MinorAR/Fontys_SCARA_Arm/README.md

# Fontys SCARA Arm project
# More information on [Wiki](https://github.com/MinorAR/Fontys_SCARA_Arm/wiki)
