MinorAR/Fontys_SCARA_Arm/img/Poster-fontys-MinorAR.pdf

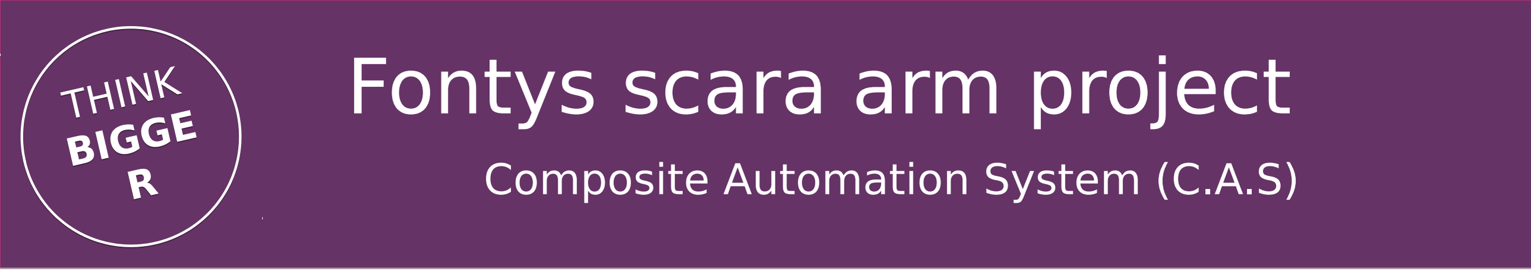
[picture p1: figure]
THINK BIGGE R; Fontys scara arm project; Composite Automation System (C.A.S)
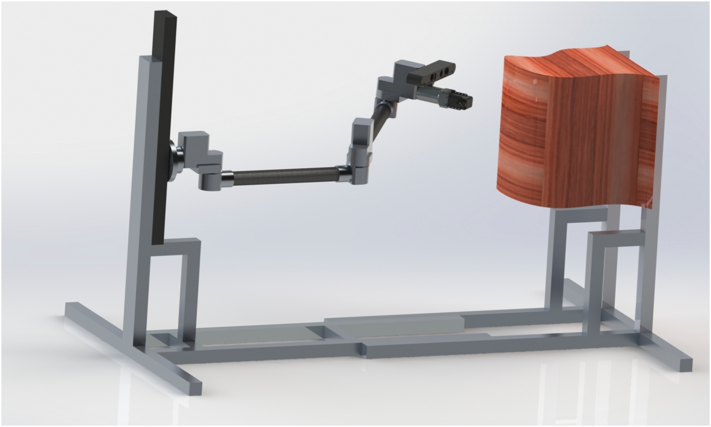
[picture p2: figure]
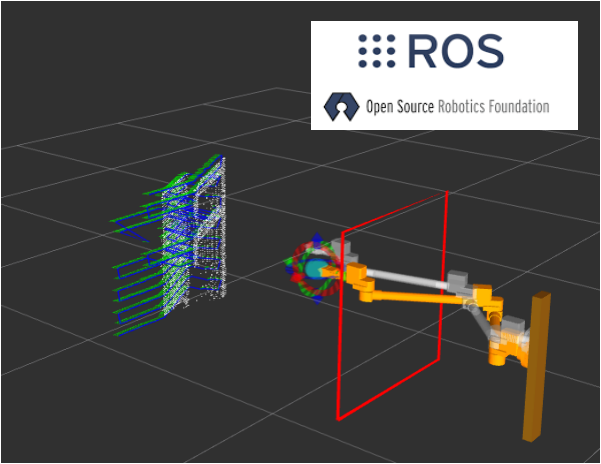
[picture p3: figure]
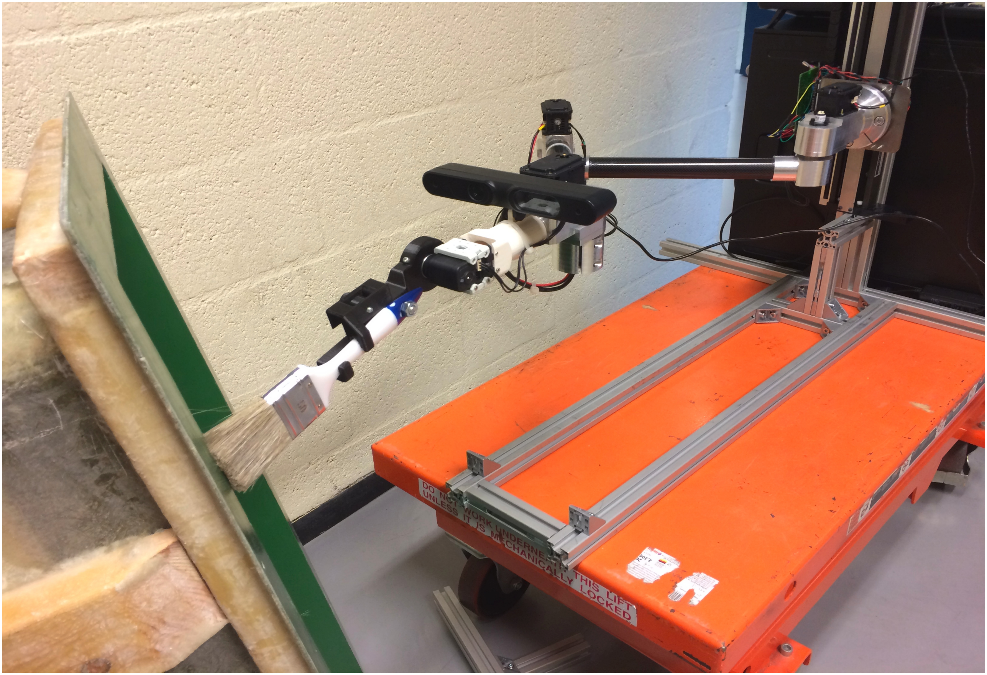
[picture p4: figure]
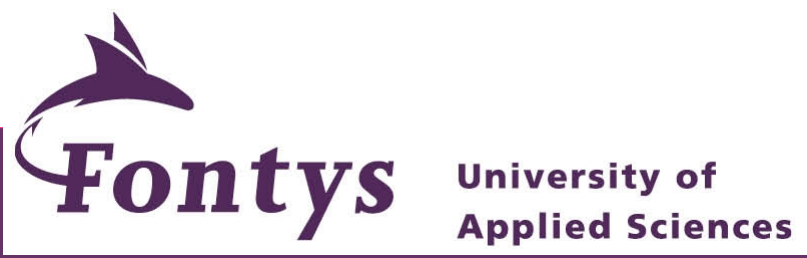
[picture p5: figure]

Fontys Hogeschool Engineering Rachelsmolen 1, 5612 MA
Eindhoven, The Netherlands

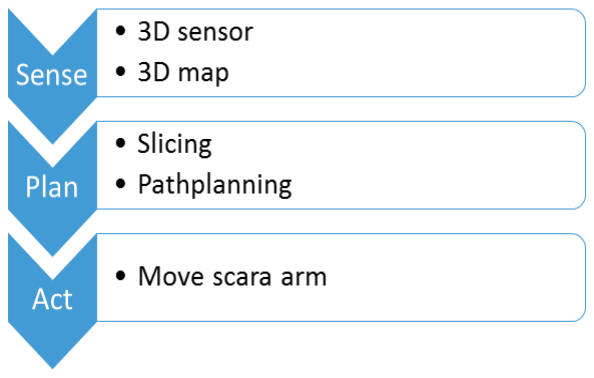
[picture p6: figure]

# Minor Adaptive Robotics

## https://github.com/MinorAR/Fontys_SCARA_Arm/wiki

## Introduction

This project within the minor Adaptive Robotics for the Fontys university of applied sciences engineerings department in Eindhoven (the Netherlands). As part of the Composite Automation System (C.A.S.)

## Project context

The process is about making products with composite materials which require a complex producing method which costs a lot of time. The following parts of process were interesting for this project which are: product polishing, cleaning the surface of the mold, and putting a gel coat. The purpose of this project is to deliver a working demonstrator that is able to detect a certain object and follow the surfaces.

## Powered by ROS

The Robot Operating System (ROS) is a flexible framework for writing robot software. It is a collection of tools, libraries, and conventions that aim to simplify the task of creating complex and robust robot behavior across a wide variety of robotic platforms.

Project members:
Ruud van Dommelen
Cas van Hoof
Wout Kanters
Jeroen Rikken
Lorenz Janssen
