MinorAR/Fontys_SCARA_Arm/src/pclcaptureing_positioning/README.md

# Service node for moveIt!

## Introduction
In this folder you will find information and all the files about how to create a node that offers a service in ROS. This service allows you to request a position that will be sent to a moveIt movegroup.

In the rqt-graph screenshot you can see that the node is present. The node contains a service and is connected to movegroup through several topics. (/trajectory_execution_event, pickup/action_topics, place/action_topics, /planning_scene and /attached collision_object).
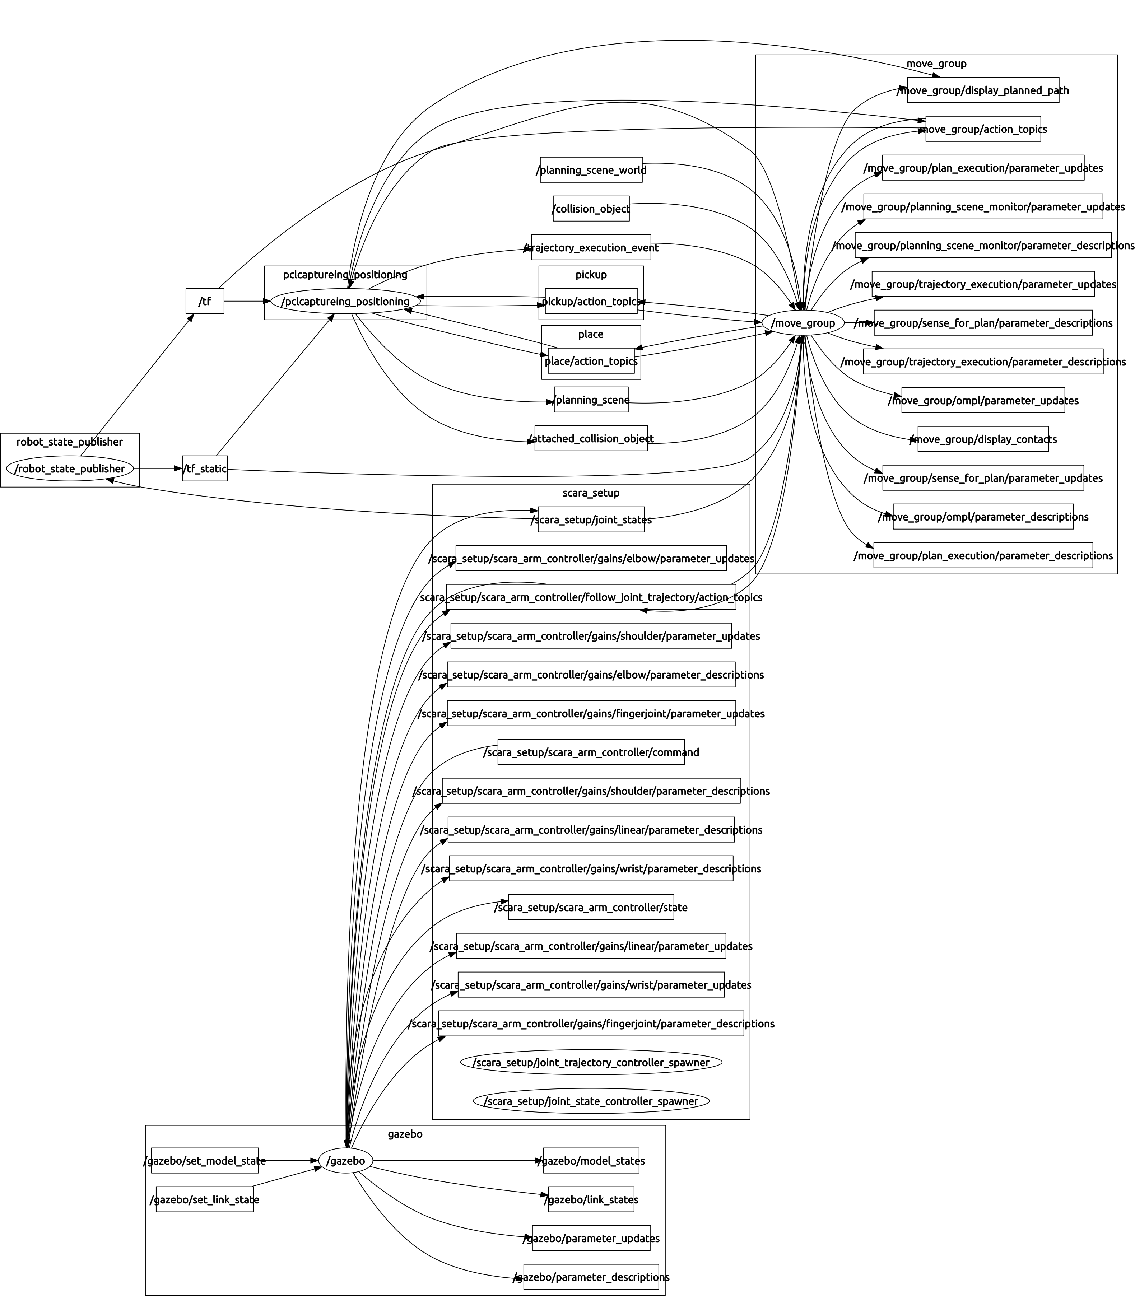
[picture p7: img/rosgraph.png]
Image of Graph


## how to use
As you can see in the picture below, the service is called with a rosservice call. You can enter the values you want to reach end the node will make sure the robot arm gets to this position. These values quaternion coordinates.
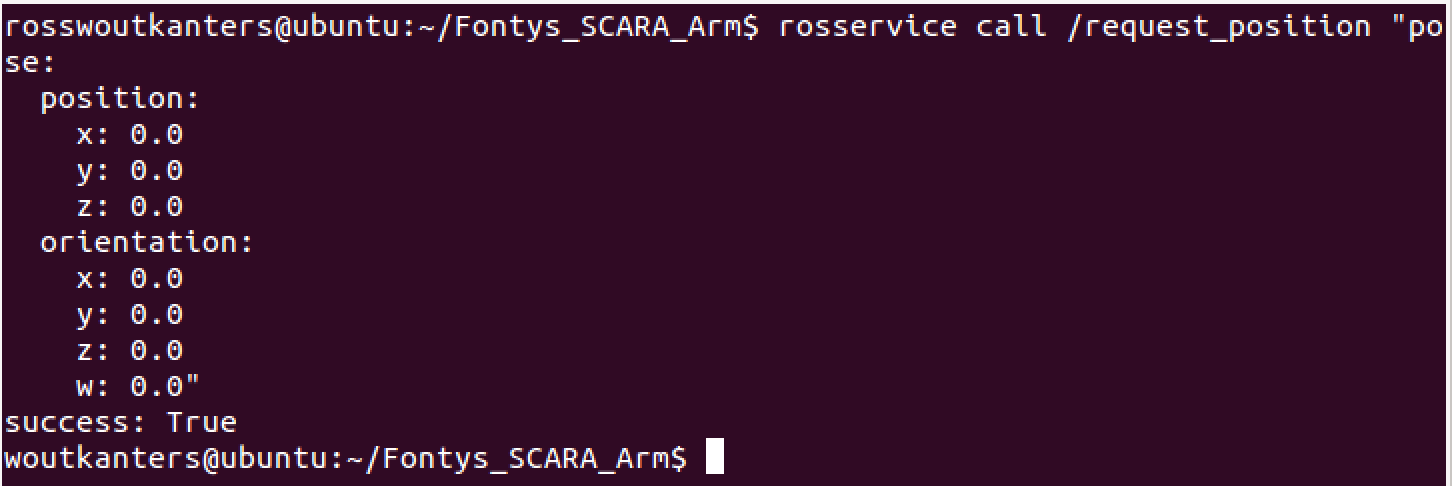
[picture p8: img/srvcall.png]
Image of Servicecall

You can see that the node sends an acknowlage back to the terminal.

## Folder contents
This is a catkin created package so the folders and most documents are automatically generated. also see: http://wiki.ros.org/catkin/Tutorials/create_a_workspace 

In the [src folder](https://github.com/MinorAR/Fontys_SCARA_Arm/tree/master/src/pclcaptureing_positioning/src) I created a C++ node for the service call.

In the [Launch folder](https://github.com/MinorAR/Fontys_SCARA_Arm/tree/master/src/pclcaptureing_positioning/launch) I created a launch file to automatically launch all vital pats of the node.

In the [srv folder](https://github.com/MinorAR/Fontys_SCARA_Arm/tree/master/src/pclcaptureing_positioning/srv) I added a service file which includes the information about how to service is build. In my case I used the /pose topic.

In this folder you can find the Cmakelist which is ajusted to compile all the parts of this folder correct.
