MinorAR/Fontys_SCARA_Arm/img/ArchitectureOverview.PNG

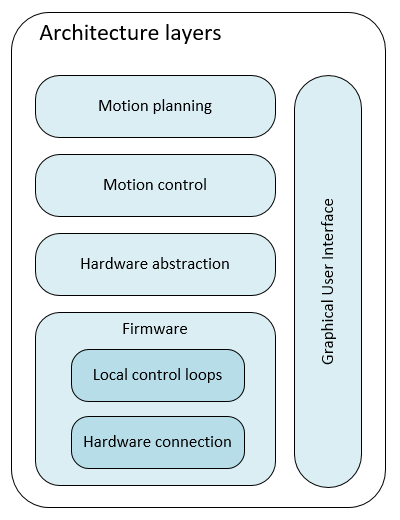
img/ArchitectureOverview.PNG
