MinorAR/Fontys_SCARA_Arm/img/Blindspots_Vision.png

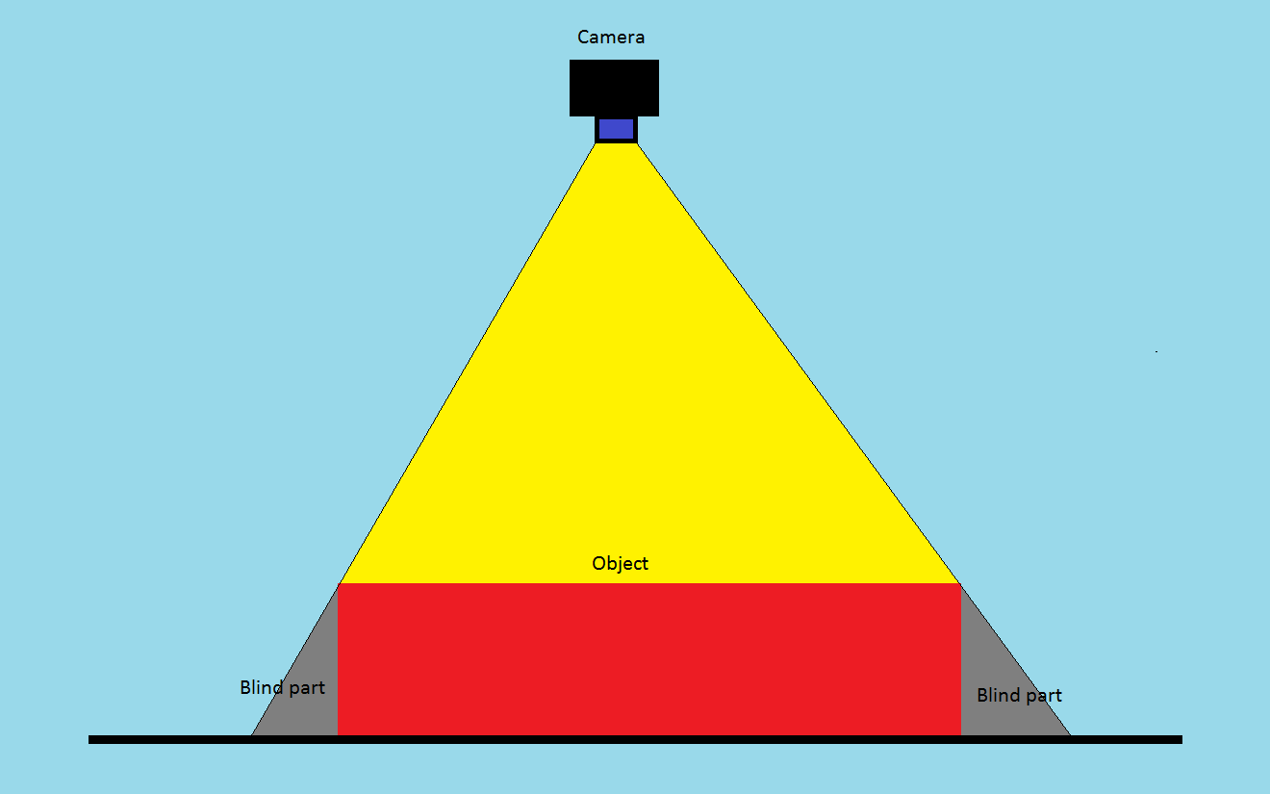
img/Blindspots_Vision.png
