MinorAR/Fontys_SCARA_Arm/img/ControlModuleOverview.png

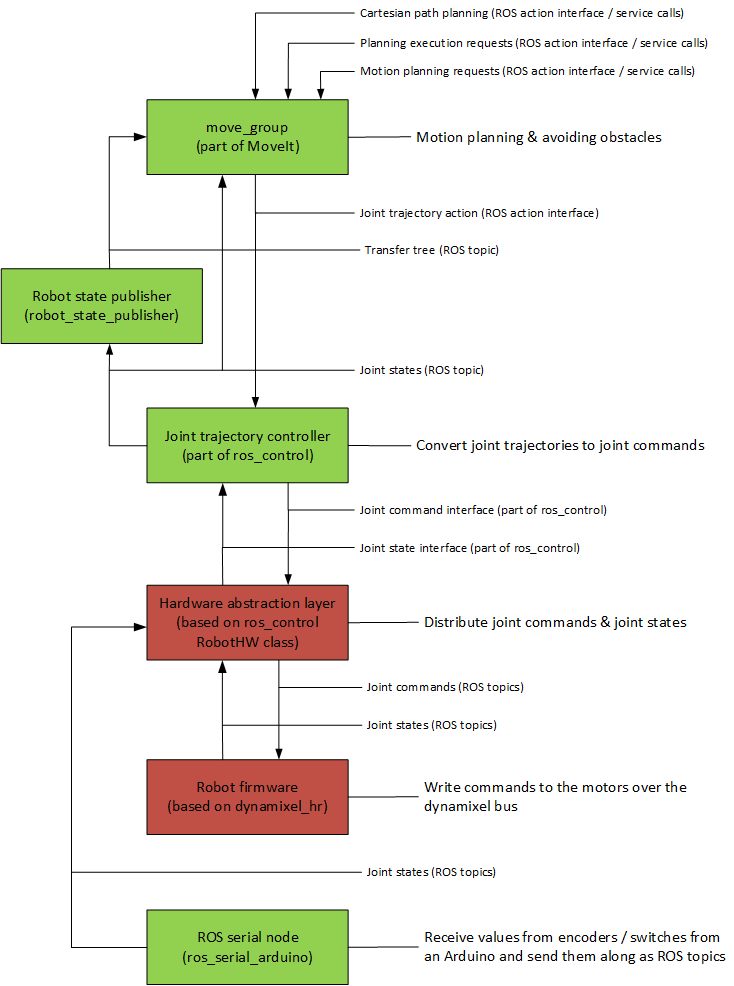
img/ControlModuleOverview.png
