MinorAR/Fontys_SCARA_Arm/img/Dynamixel_AX-12-spec.png

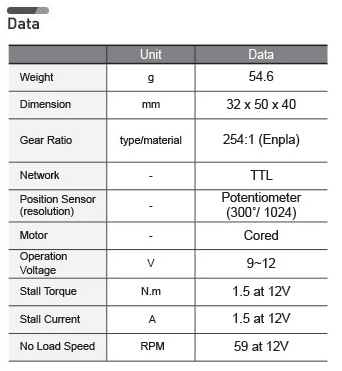
img/Dynamixel_AX-12-spec.png
