MinorAR/Fontys_SCARA_Arm/img/Dynamixel_MX-64-spec.png

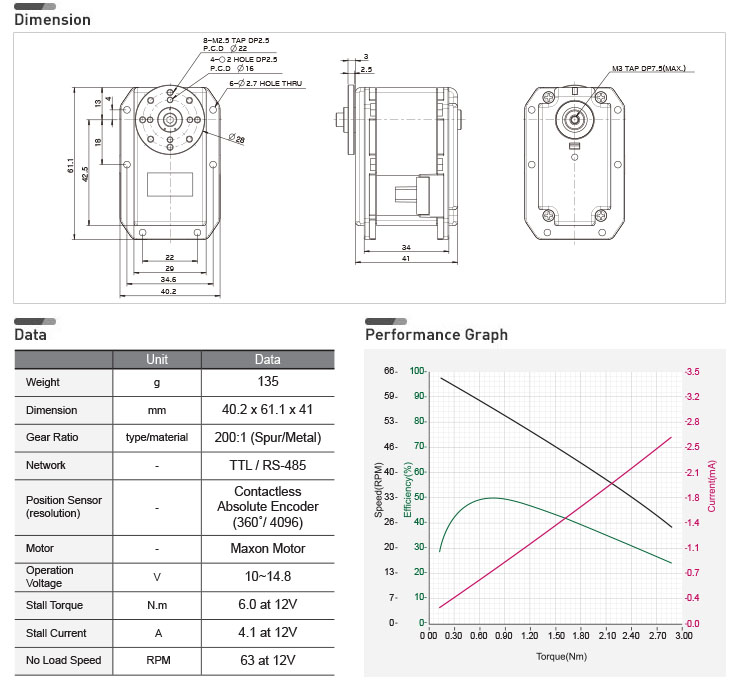
img/Dynamixel_MX-64-spec.png
