MinorAR/Fontys_SCARA_Arm/img/flowchartVS.png

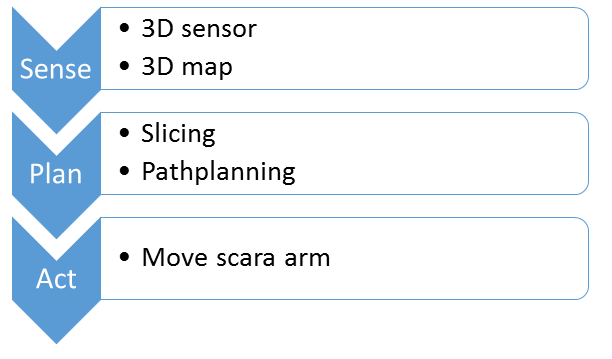
img/flowchartVS.png
