MinorAR/Fontys_SCARA_Arm/img/foto frame cad.png

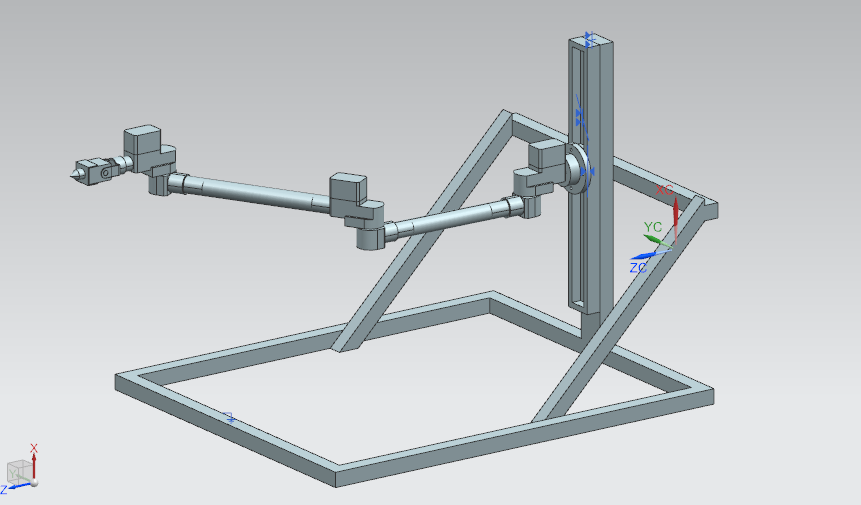
img/foto frame cad.png
