MinorAR/Fontys_SCARA_Arm/img/global block diagram.png

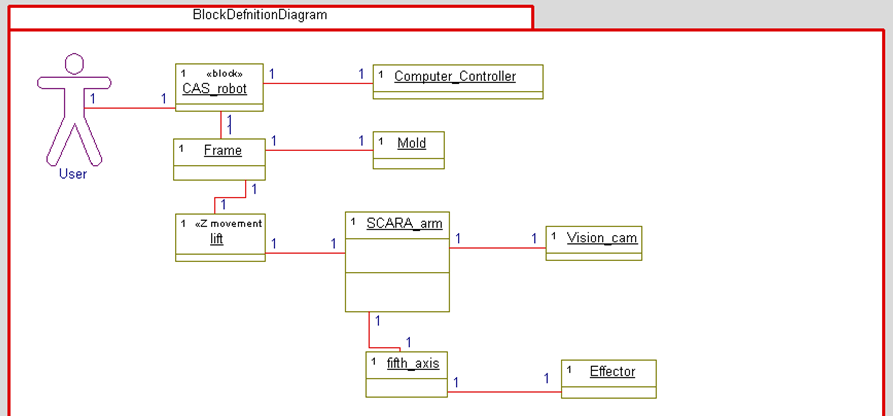
img/global block diagram.png
