MinorAR/Fontys_SCARA_Arm/img/header.png

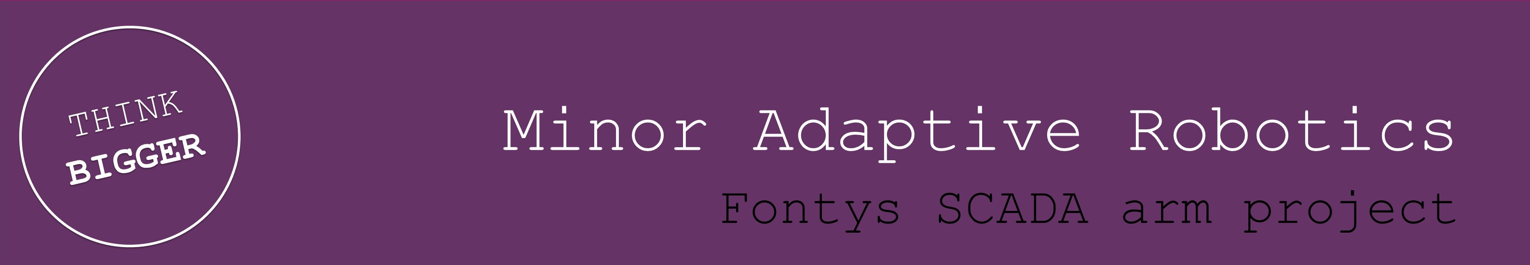
img/header.png
