MinorAR/Fontys_SCARA_Arm/img/process digitaal.PNG

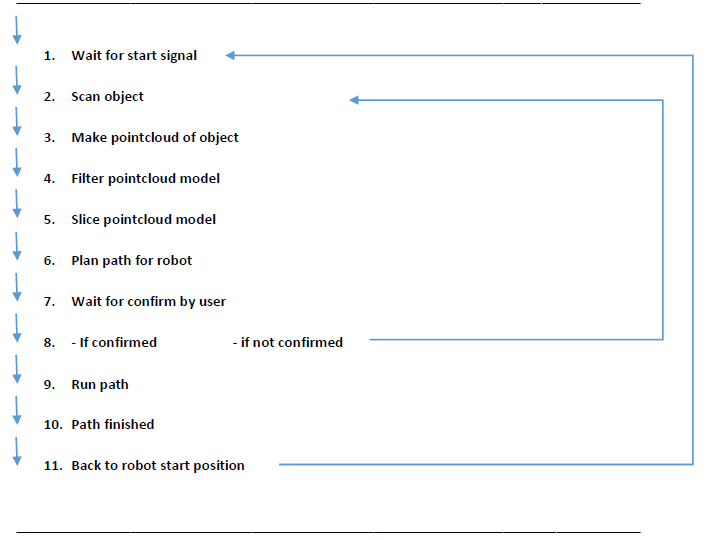
img/process digitaal.PNG
