MinorAR/Fontys_SCARA_Arm/img/Safety Check.png

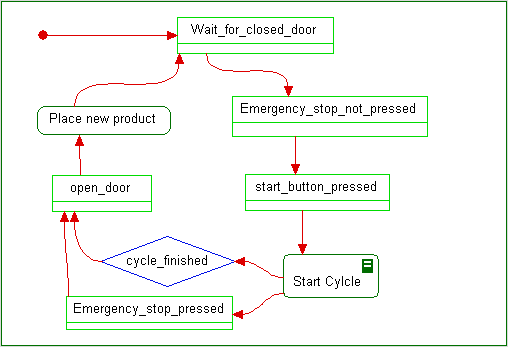
img/Safety Check.png
