MinorAR/Fontys_SCARA_Arm/img/Safety Zone.png

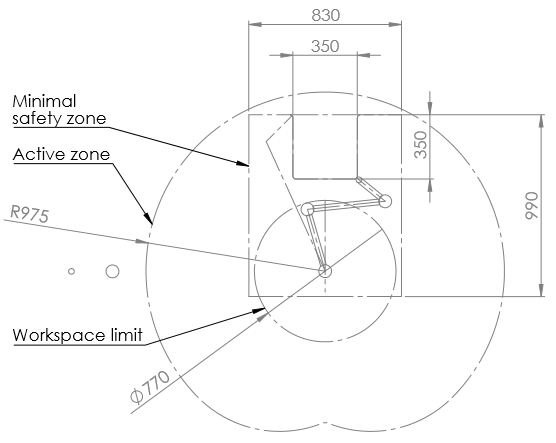
img/Safety Zone.png
