MinorAR/Fontys_SCARA_Arm/img/SCARA_pic_1.png

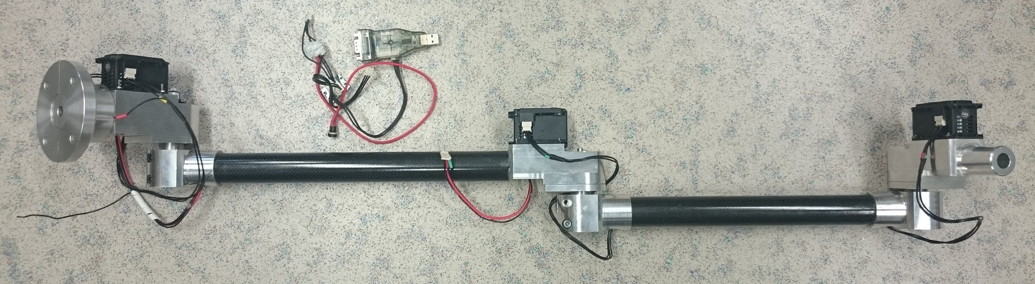
img/SCARA_pic_1.png
