MinorAR/Fontys_SCARA_Arm/img/SCARA_pic_2.png

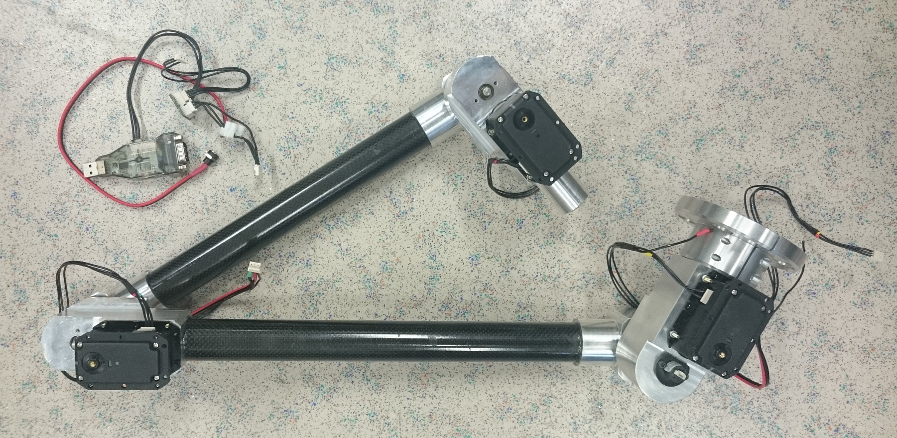
img/SCARA_pic_2.png
