MinorAR/Fontys_SCARA_Arm/img/scaradimensions.png

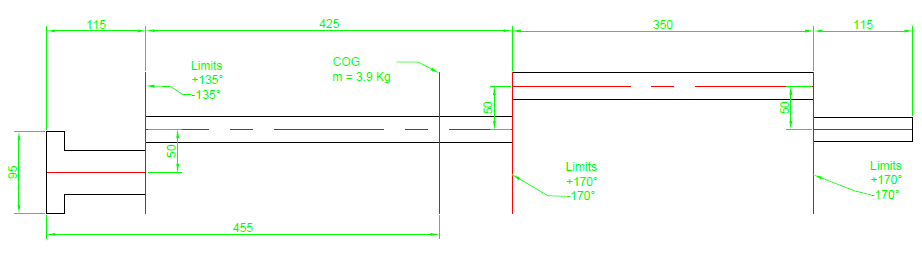
img/scaradimensions.png
