MinorAR/Fontys_SCARA_Arm/img/Screenshot from 2016-06-09 13:05:24.png

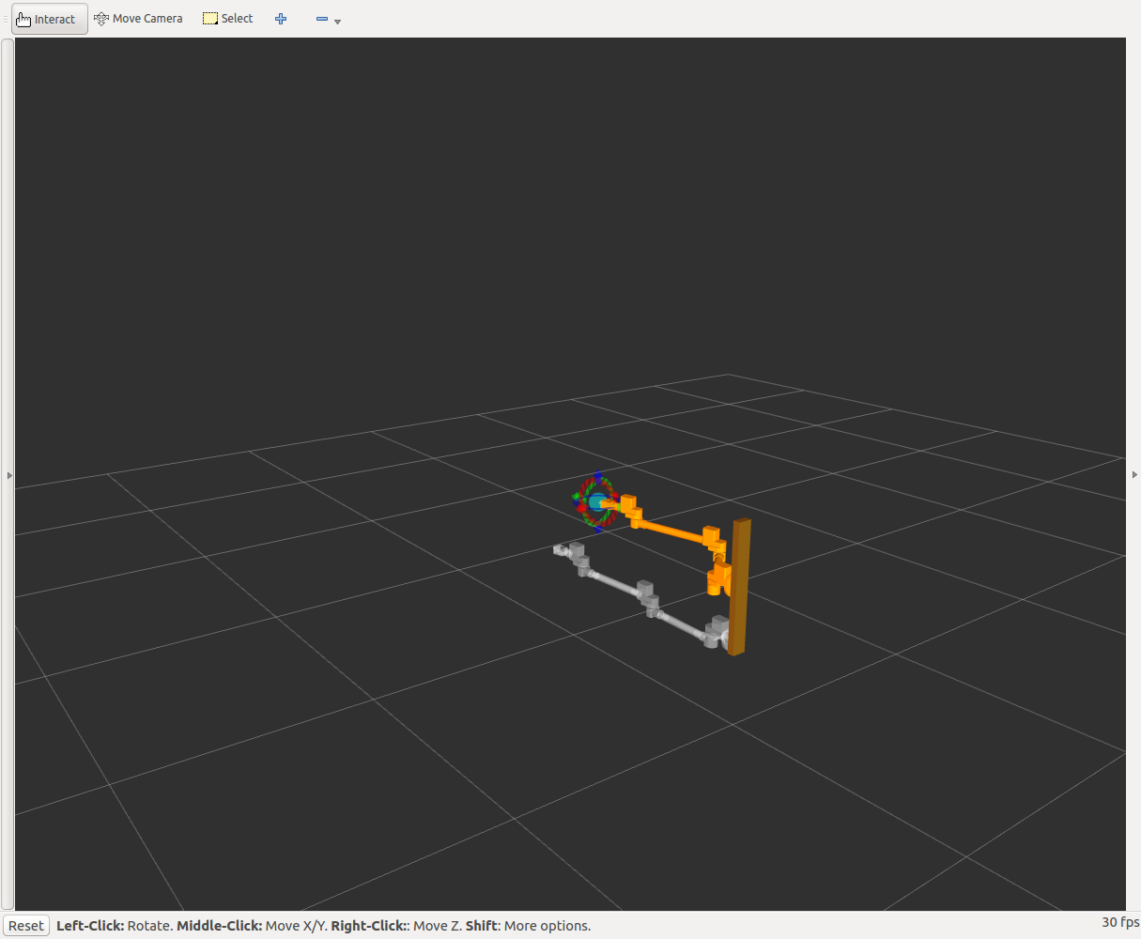
img/Screenshot from 2016-06-09 13:05:24.png
