MinorAR/Fontys_SCARA_Arm/img/Screenshot from 2016-06-09 13:08:11.png

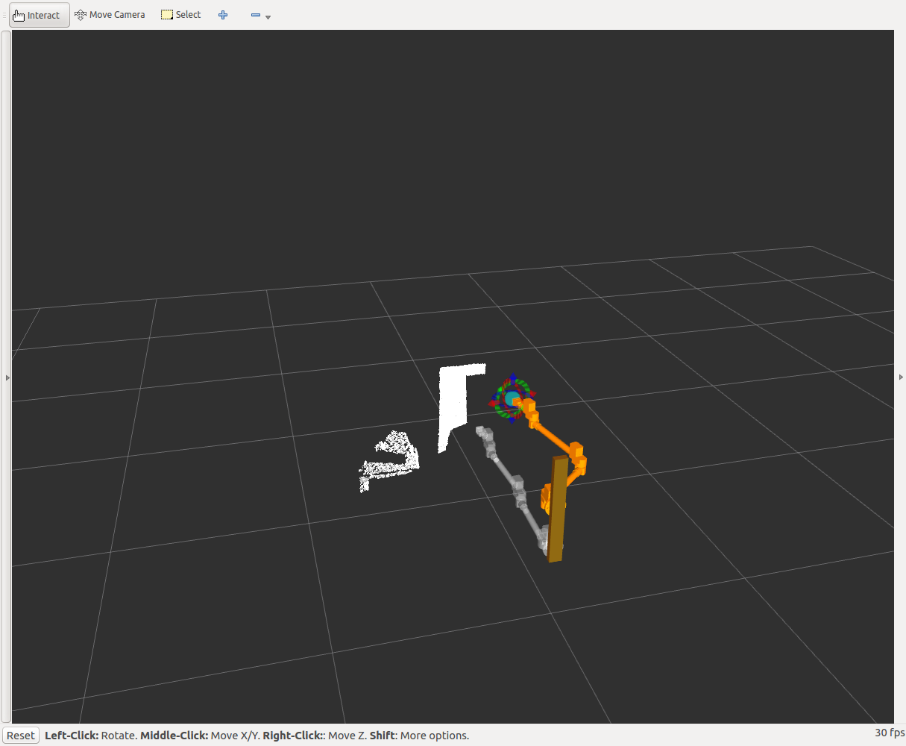
img/Screenshot from 2016-06-09 13:08:11.png
