MinorAR/Fontys_SCARA_Arm/img/Screenshot from 2016-06-09 13:09:03.png

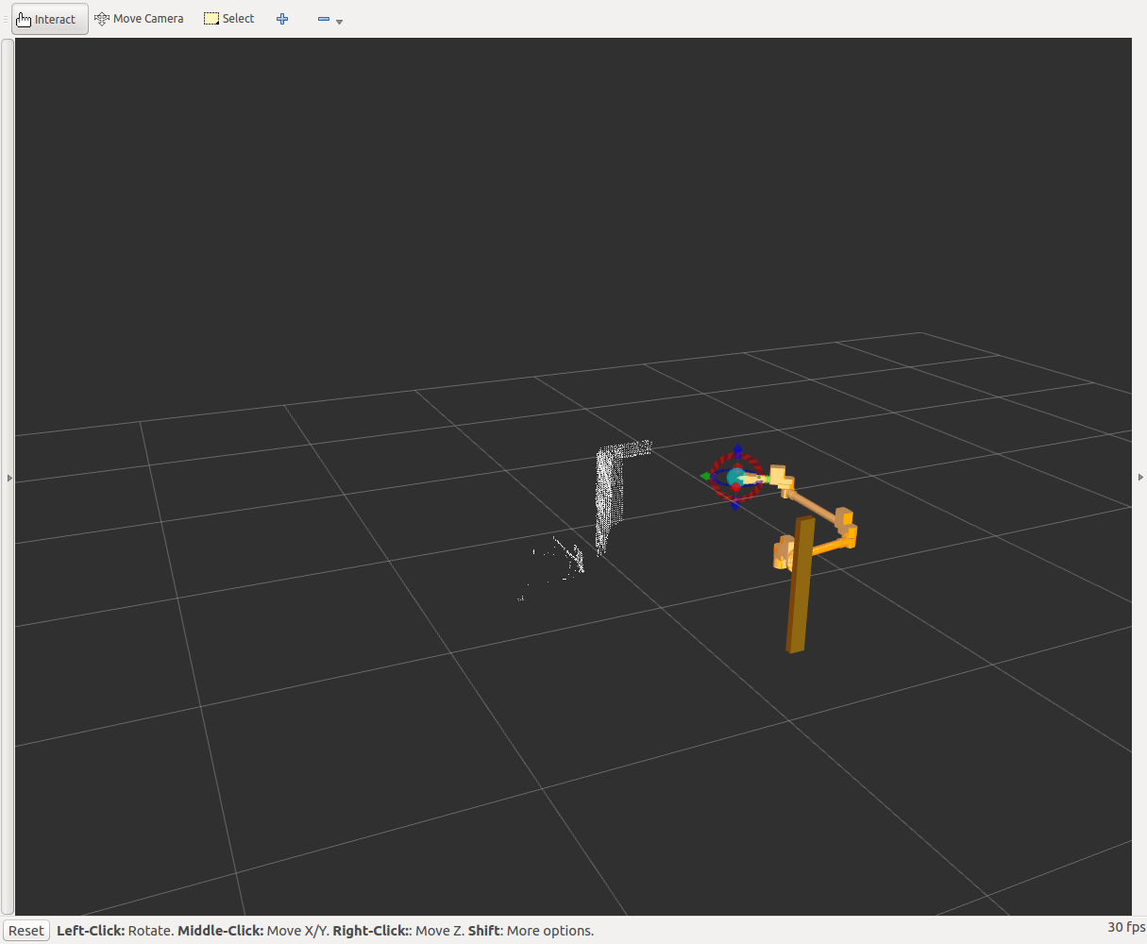
img/Screenshot from 2016-06-09 13:09:03.png
