MinorAR/Fontys_SCARA_Arm/img/servicecall.png

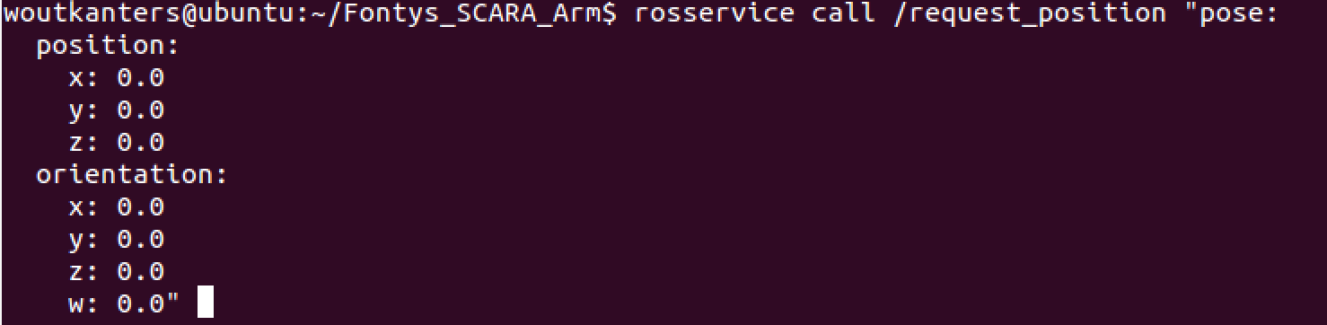
img/servicecall.png
