MinorAR/Fontys_SCARA_Arm/img/situatie1.png

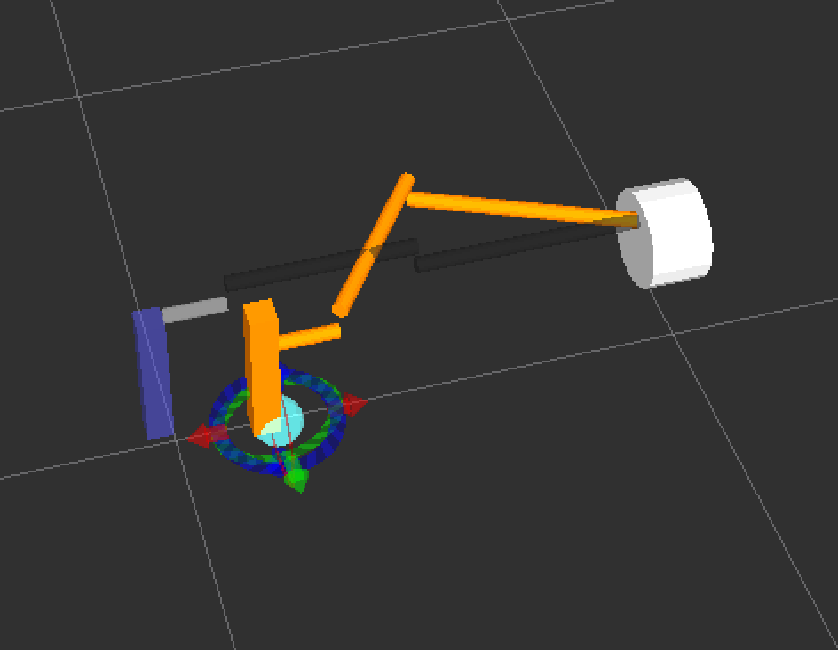
img/situatie1.png
