MinorAR/Fontys_SCARA_Arm/img/situatie2.png

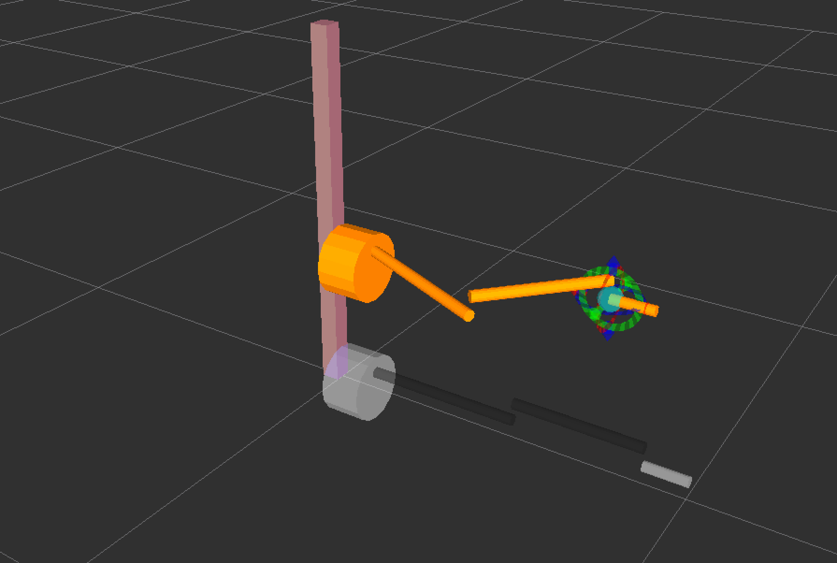
img/situatie2.png
