MinorAR/Fontys_SCARA_Arm/img/situatie3.png

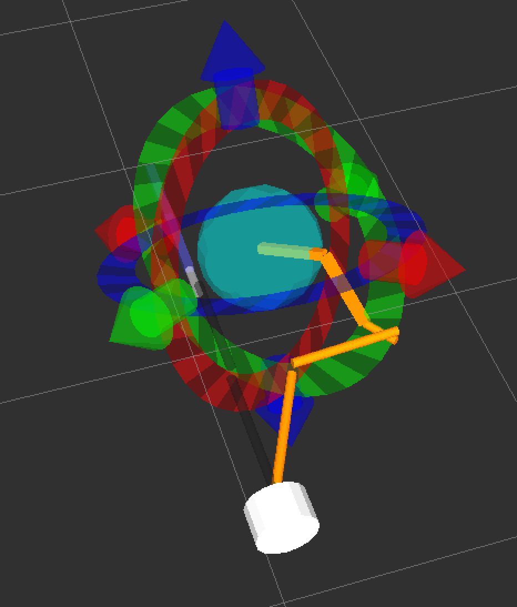
img/situatie3.png
