MinorAR/Fontys_SCARA_Arm/img/MoveItComponents.png

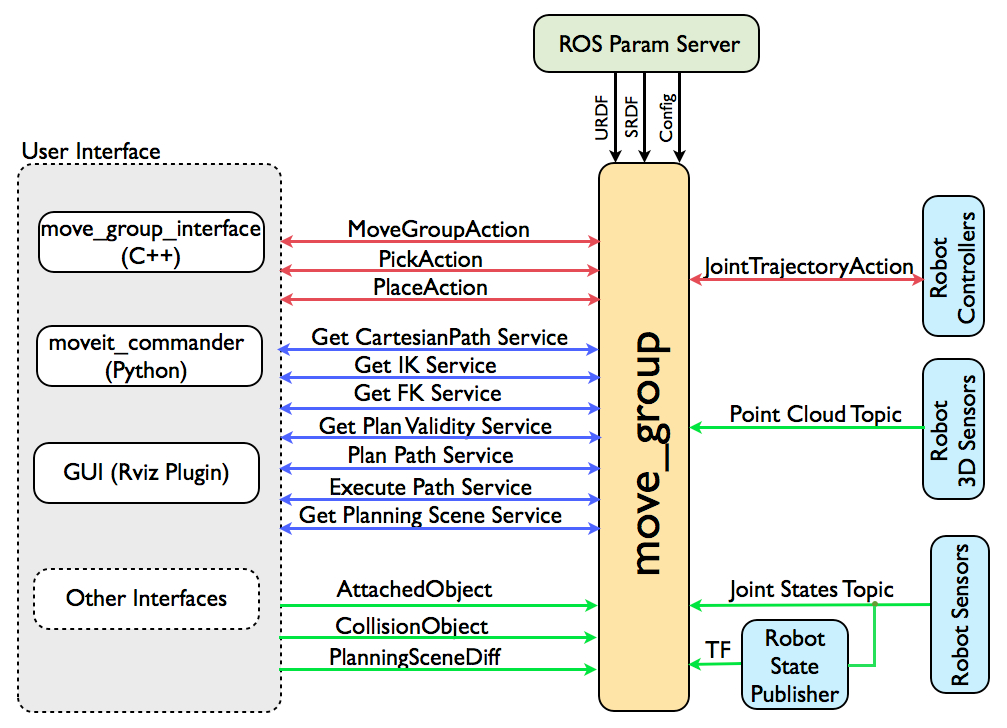
img/MoveItComponents.png
