MinorAR/Fontys_SCARA_Arm/CAD/total assembly.SLDASM

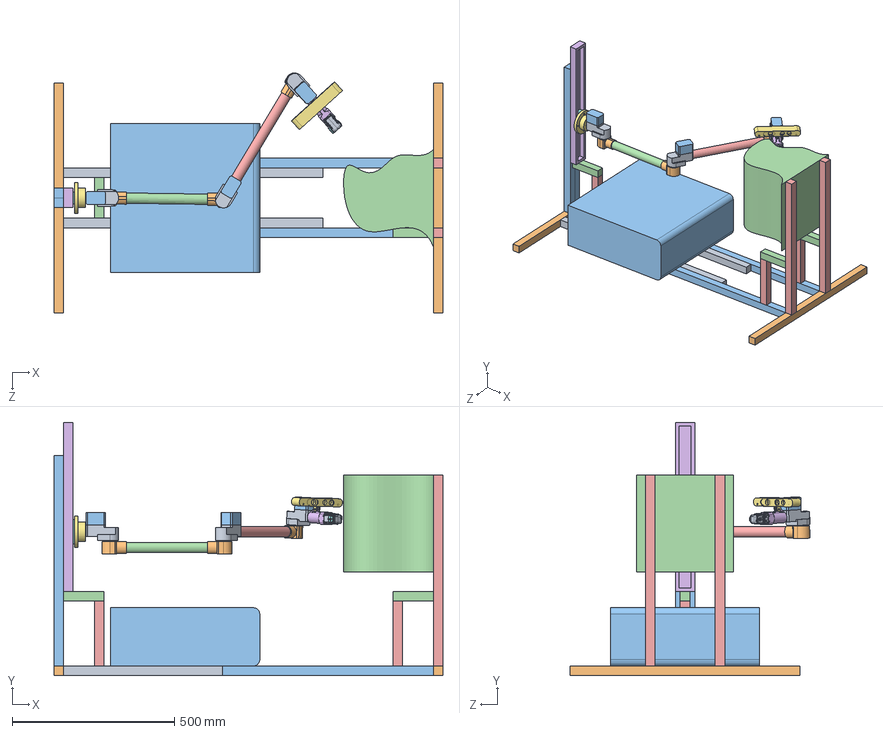
[picture p33: CAD file, 2016-06-23]
CAD/total assembly.SLDASM
1200.0 x 782.0 x 740.3 mm
30x800 x 2
30x710 x 2
30x650 x 4
30x125 x 5
30x200 x 3
LinearGuide
Base
LinearGuideCart
Joint_Motor_Side x 3
Joint_Passive_Side x 3
Motor_MX-64 x 3
Arm
ForeArm
end effector beugel
camera_sldprt
ax12_wheel
ax12_box
ax12_cog
pc
object 300x300x300
30x590 x 2
