MinorAR/Fontys_SCARA_Arm/CAD/mechanical make parts cad/Assem1.SLDASM

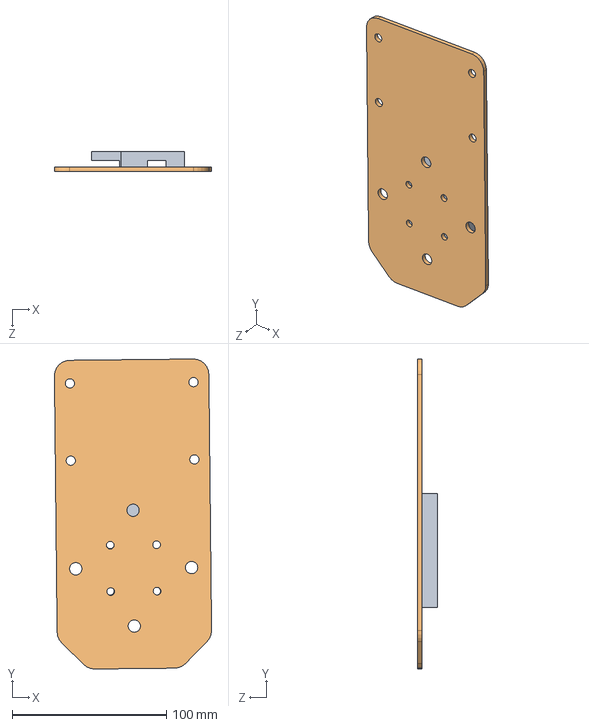
[picture p34: CAD file, 2016-06-23]
CAD/mechanical make parts cad/Assem1.SLDASM
101.7 x 200.7 x 13.0 mm
bevestigingplaat van lift
bevestigingsflens voor arm
