MinorAR/Fontys_SCARA_Arm/CAD/AX12.SLDASM

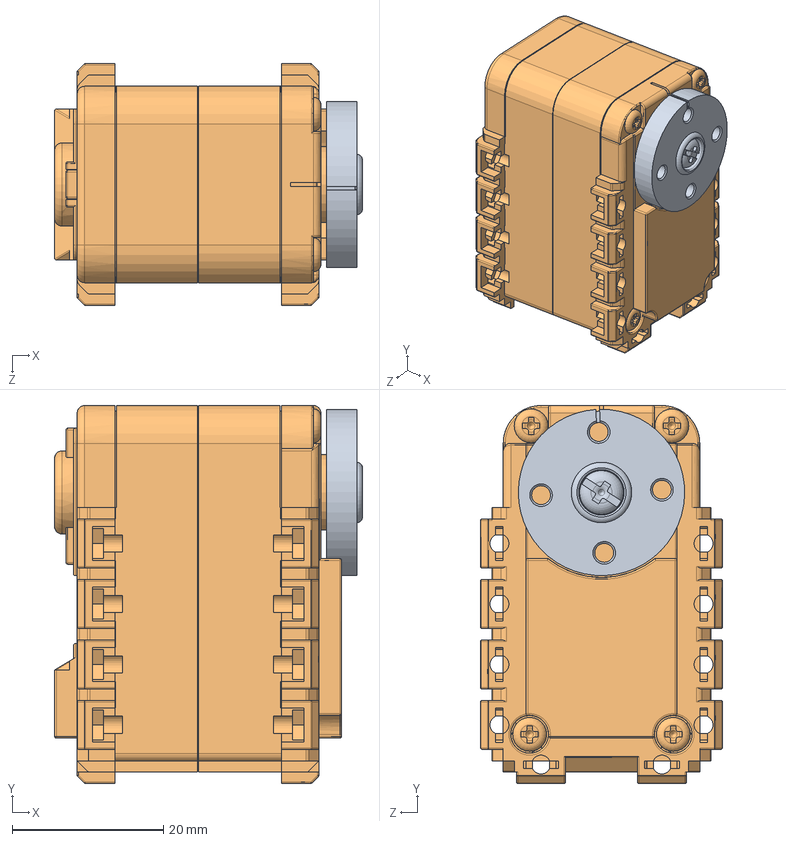
[picture p35: CAD file, 2016-06-23]
CAD/AX12.SLDASM
40.8 x 50.0 x 32.0 mm
ax12_wheel
ax12_box
ax12_cog
