MinorAR/Fontys_SCARA_Arm/CAD/effector1/assembly effector.SLDASM

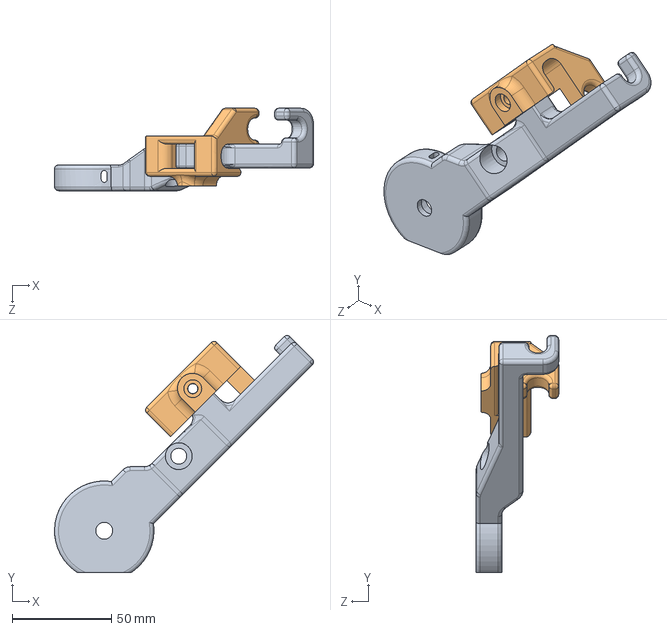
[picture p36: CAD file, 2016-06-23]
CAD/effector1/assembly effector.SLDASM
130.2 x 119.2 x 41.5 mm
effector
klem effector
