MinorAR/Fontys_SCARA_Arm/CAD/frame/frame assembly.SLDASM

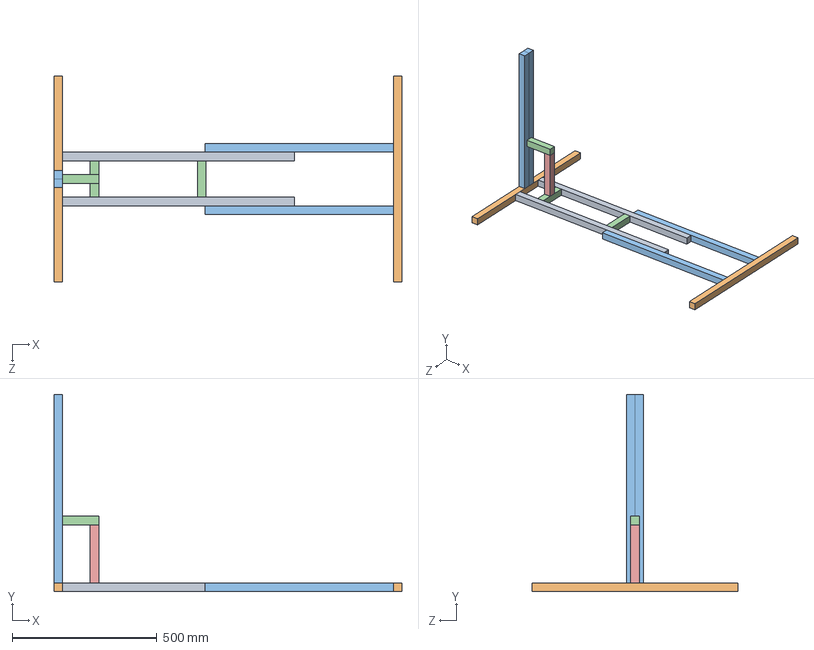
[picture p37: CAD file, 2016-06-23]
CAD/frame/frame assembly.SLDASM
1200.0 x 680.0 x 710.0 mm
30x800 x 2
30x710 x 2
30x650 x 4
30x125 x 3
30x200
