MinorAR/Fontys_SCARA_Arm/CAD/effector1/effector.SLDPRT

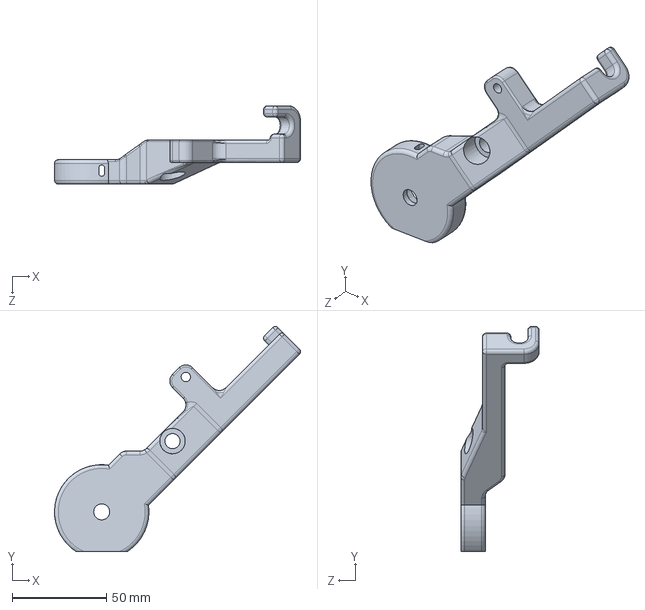
[picture p38: CAD file, 2016-06-23]
CAD/effector1/effector.SLDPRT
130.2 x 119.2 x 41.5 mm
