MinorAR/Fontys_SCARA_Arm/CAD/effector1/for printing/klem effector.STL

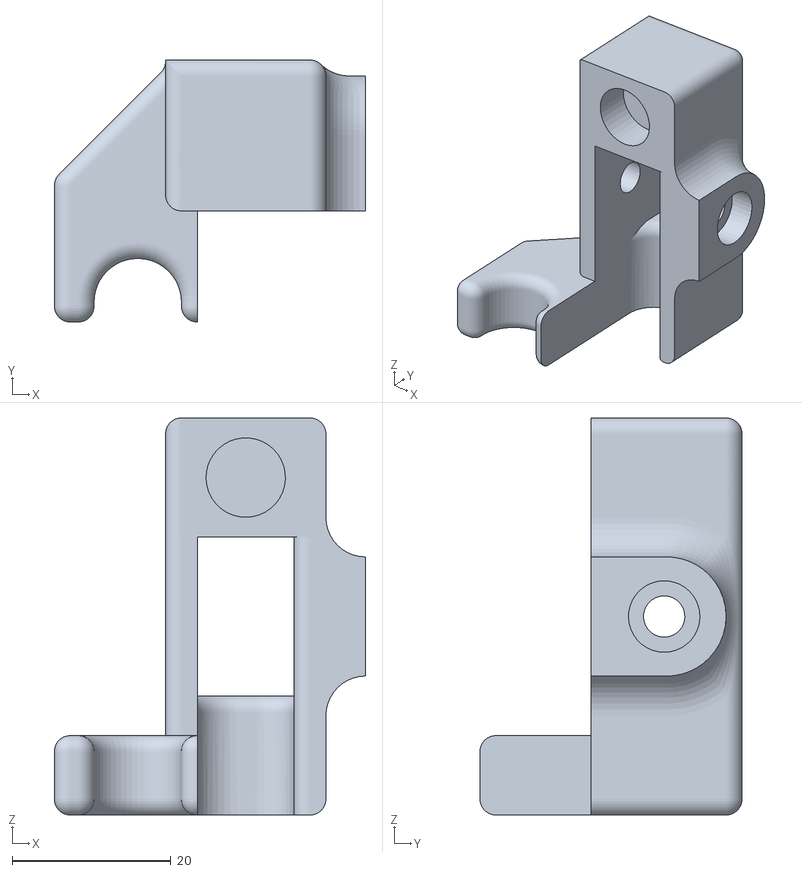
[picture p39: CAD file, 2016-06-23]
CAD/effector1/for printing/klem effector.STL
39.2 x 33.0 x 50.0
