MinorAR/Fontys_SCARA_Arm/CAD/frame/30x800.SLDPRT

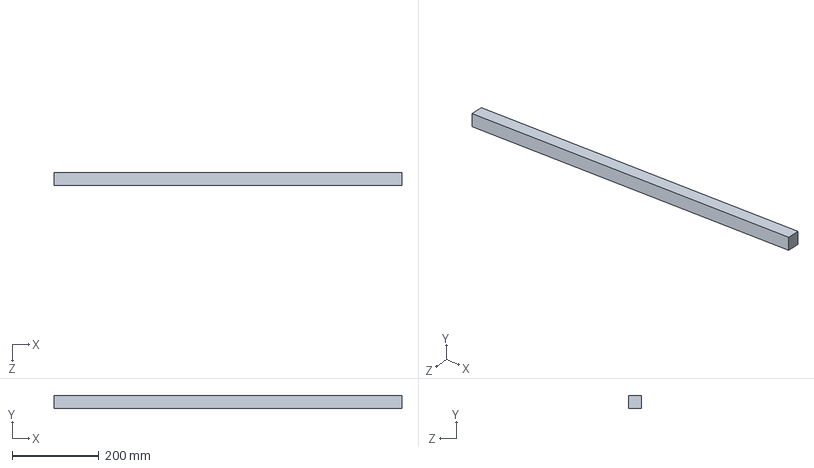
[picture p40: CAD file, 2016-06-23]
CAD/frame/30x800.SLDPRT
800.0 x 30.0 x 30.0 mm
