MinorAR/Fontys_SCARA_Arm/CAD/mechanical make parts cad/bevestigingplaat van lift.SLDPRT

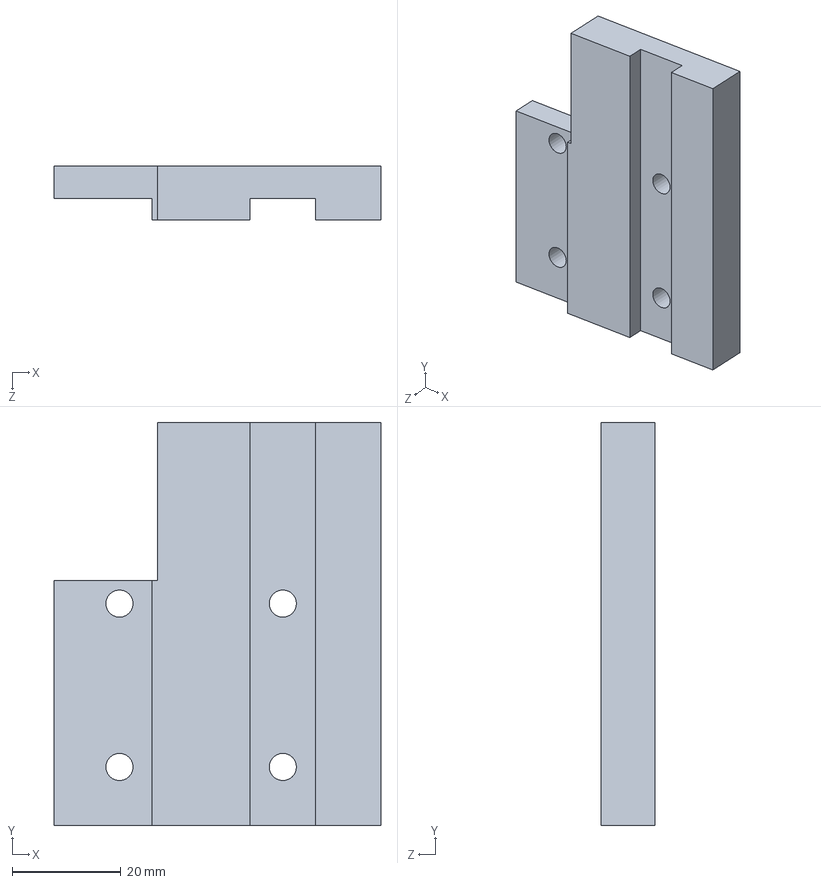
[picture p41: CAD file, 2016-06-23]
CAD/mechanical make parts cad/bevestigingplaat van lift.SLDPRT
60.0 x 74.0 x 10.0 mm
