MinorAR/Fontys_SCARA_Arm/CAD/pc.SLDPRT

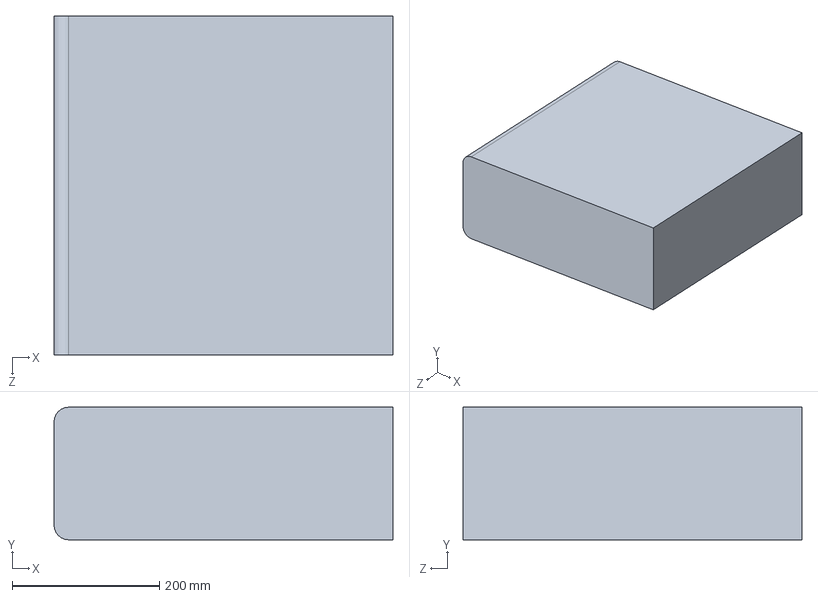
[picture p42: CAD file, 2016-06-23]
CAD/pc.SLDPRT
460.0 x 180.0 x 460.0 mm
