MinorAR/Fontys_SCARA_Arm/src/scara_setup_description/meshes/arm.STL

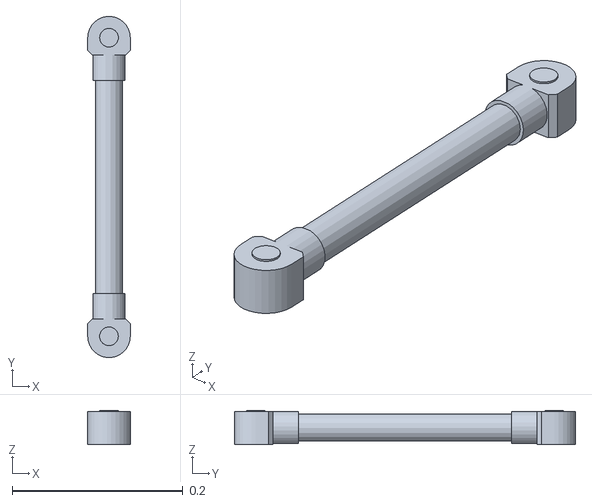
[picture p43: CAD file, 2016-05-09]
src/scara_setup_description/meshes/arm.STL
0.05 x 0.4 x 0.04
