MinorAR/Fontys_SCARA_Arm/CAD/effector1/clutch.SLDPRT

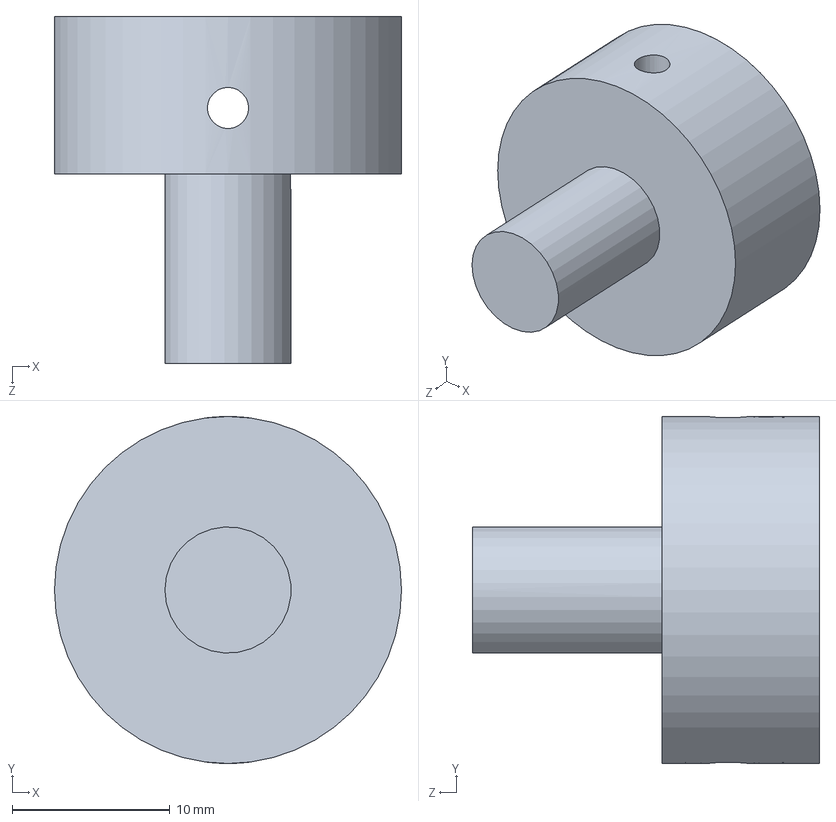
[picture p44: CAD file, 2016-06-23]
CAD/effector1/clutch.SLDPRT
22.0 x 22.0 x 22.0 mm
