MinorAR/Fontys_SCARA_Arm/CAD/frame/30x590.SLDPRT

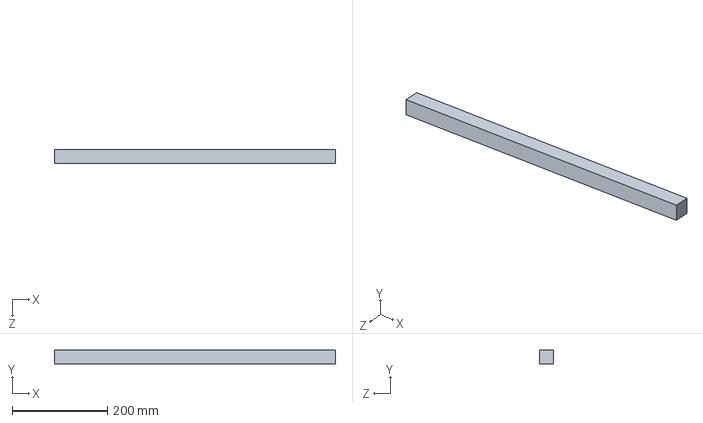
[picture p45: CAD file, 2016-06-23]
CAD/frame/30x590.SLDPRT
590.0 x 30.0 x 30.0 mm
