MinorAR/Fontys_SCARA_Arm/CAD/mechanical make parts cad/bevestigingsflens voor arm.SLDPRT

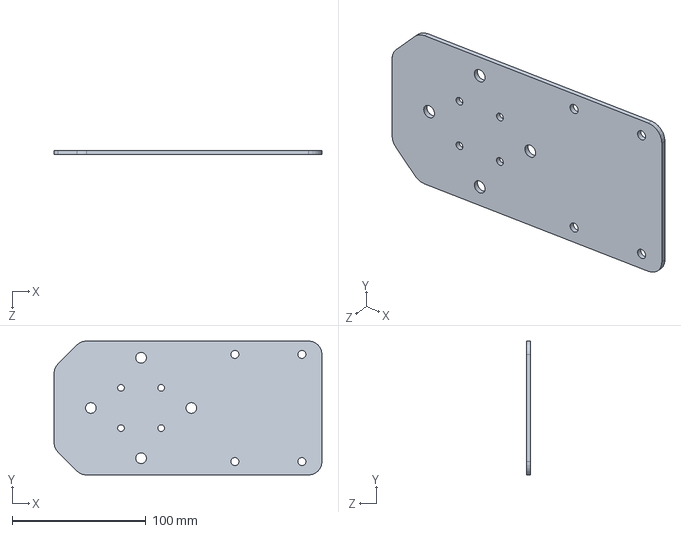
[picture p46: CAD file, 2016-06-23]
CAD/mechanical make parts cad/bevestigingsflens voor arm.SLDPRT
200.0 x 100.0 x 3.00 mm
