MinorAR/Fontys_SCARA_Arm/src/scara_setup_description/meshes/cart.STL

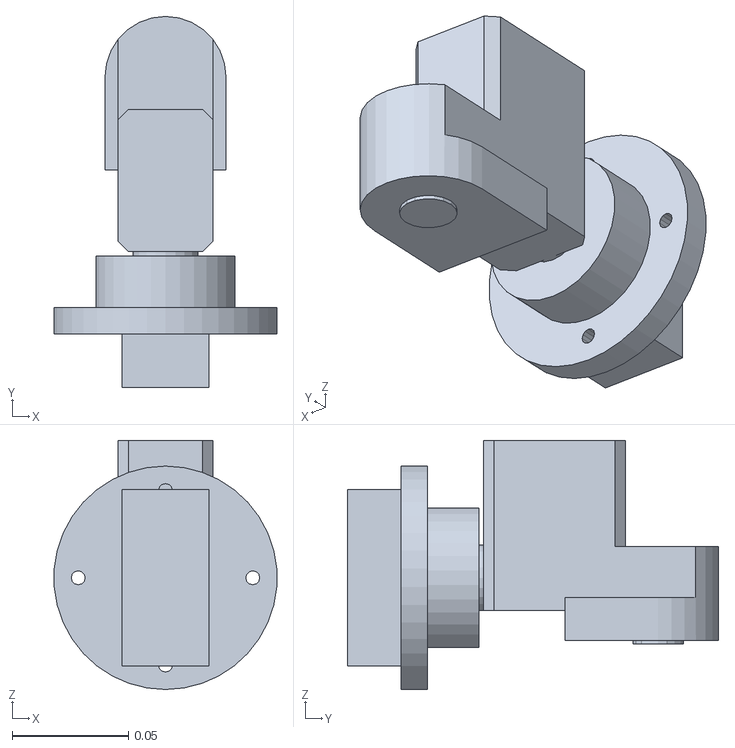
[picture p47: CAD file, 2016-05-09]
src/scara_setup_description/meshes/cart.STL
0.0957 x 0.16 x 0.107
