MinorAR/Fontys_SCARA_Arm/CAD/frame/30x200.SLDPRT

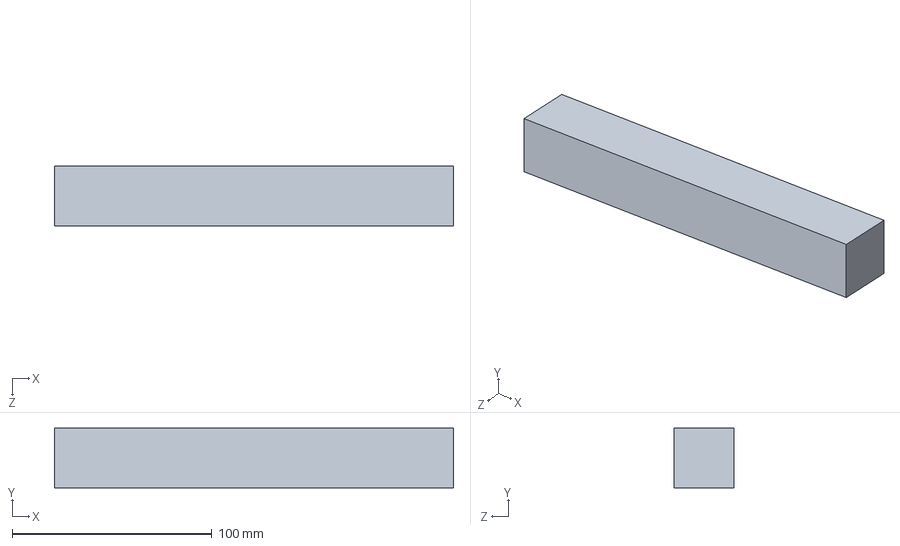
[picture p48: CAD file, 2016-06-23]
CAD/frame/30x200.SLDPRT
200.0 x 30.0 x 30.0 mm
