MinorAR/Fontys_SCARA_Arm/CAD/object 300x300x300.SLDPRT

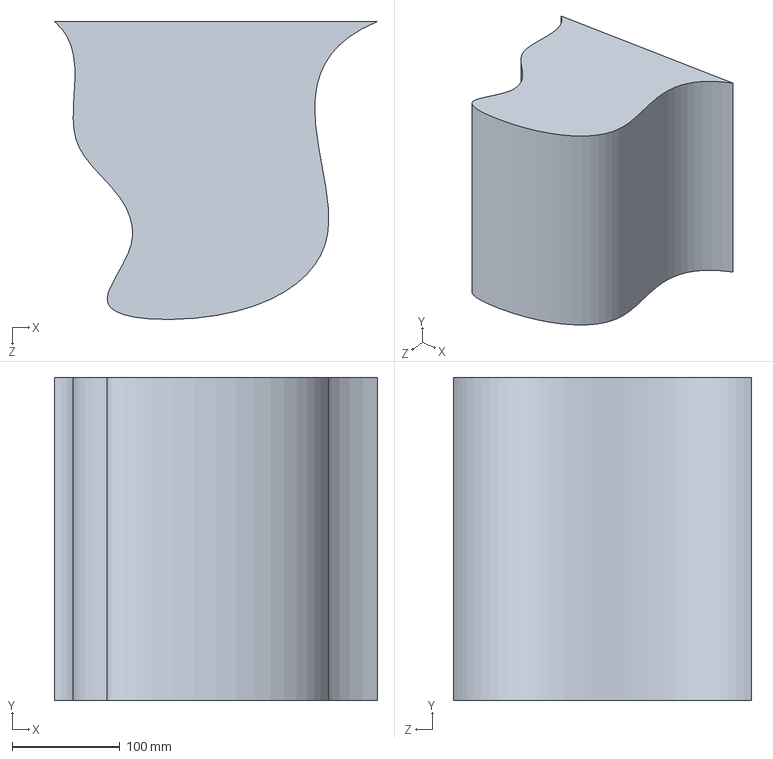
[picture p49: CAD file, 2016-06-23]
CAD/object 300x300x300.SLDPRT
300.0 x 300.0 x 276.7 mm
