MinorAR/Fontys_SCARA_Arm/src/scara_setup_description/meshes/forearm.STL

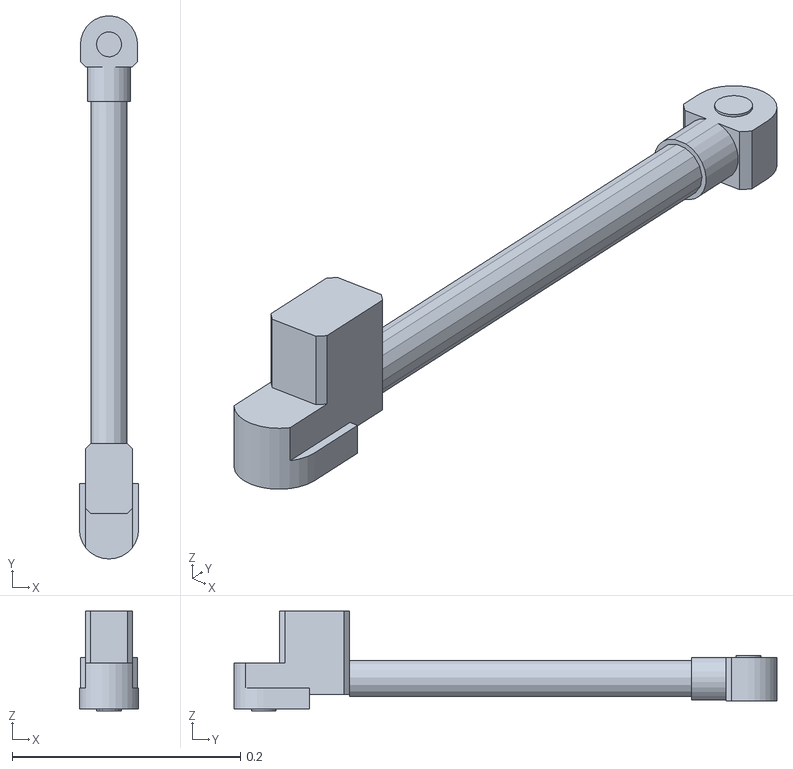
[picture p50: CAD file, 2016-05-09]
src/scara_setup_description/meshes/forearm.STL
0.052 x 0.476 x 0.0875
