MinorAR/Fontys_SCARA_Arm/CAD/frame/30x710.SLDPRT

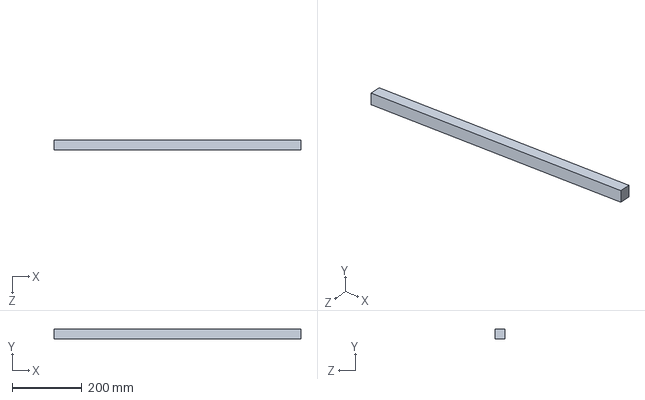
[picture p51: CAD file, 2016-06-23]
CAD/frame/30x710.SLDPRT
710.0 x 30.0 x 30.0 mm
