MinorAR/Fontys_SCARA_Arm/src/scara_setup_description/meshes/frame.STL

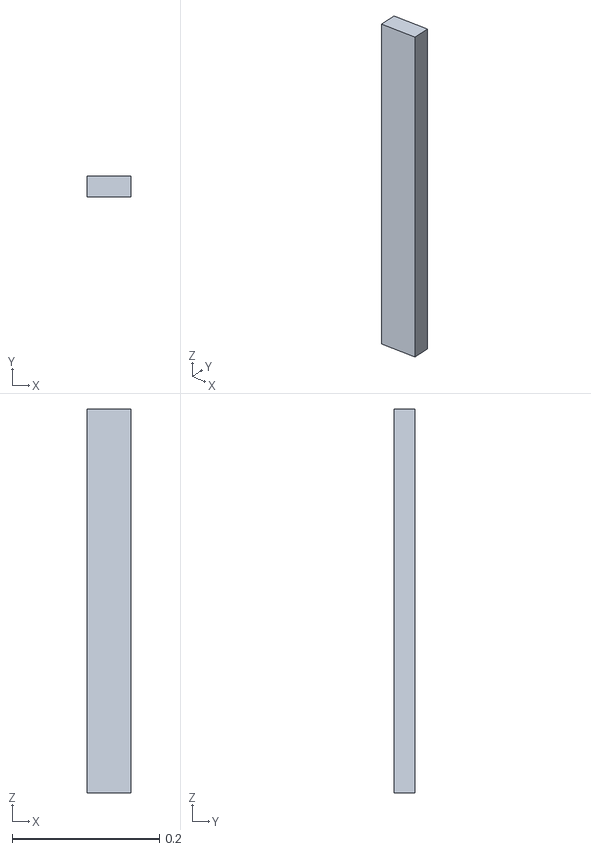
[picture p52: CAD file, 2016-05-09]
src/scara_setup_description/meshes/frame.STL
0.06 x 0.029 x 0.522
