MinorAR/Fontys_SCARA_Arm/CAD/frame/30x650.SLDPRT

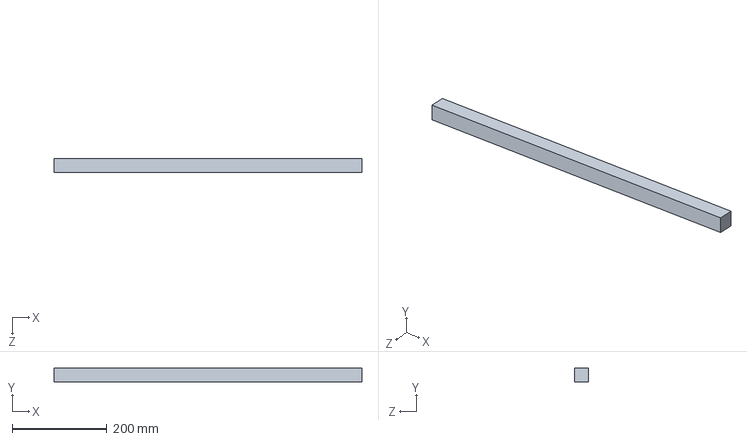
[picture p53: CAD file, 2016-06-23]
CAD/frame/30x650.SLDPRT
650.0 x 30.0 x 30.0 mm
