MinorAR/Fontys_SCARA_Arm/src/scara_setup_description/meshes/finger.STL

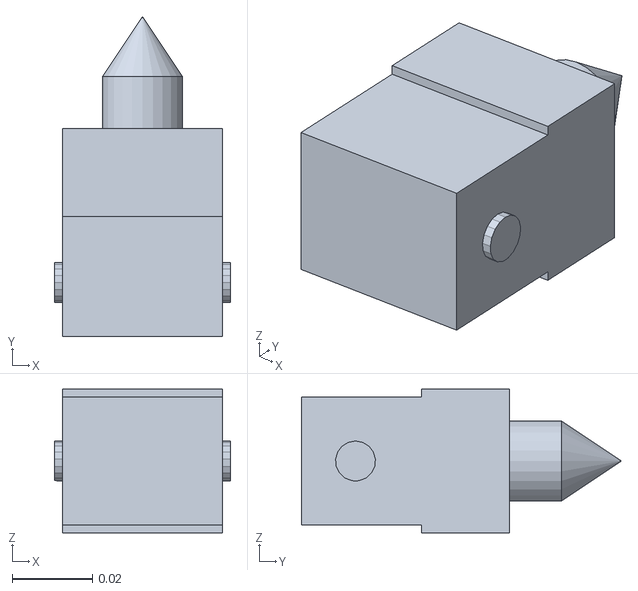
[picture p54: CAD file, 2016-05-09]
src/scara_setup_description/meshes/finger.STL
0.044 x 0.08 x 0.036
