MinorAR/Fontys_SCARA_Arm/CAD/frame/30x125.SLDPRT

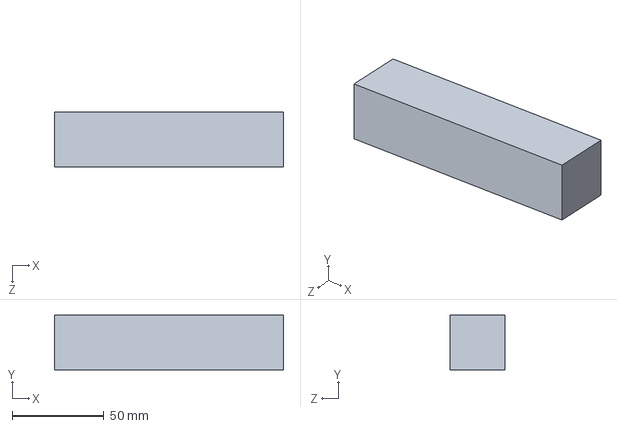
[picture p55: CAD file, 2016-06-23]
CAD/frame/30x125.SLDPRT
125.0 x 30.0 x 30.0 mm
