MinorAR/Fontys_SCARA_Arm/src/scara_setup_description/meshes/hand.STL

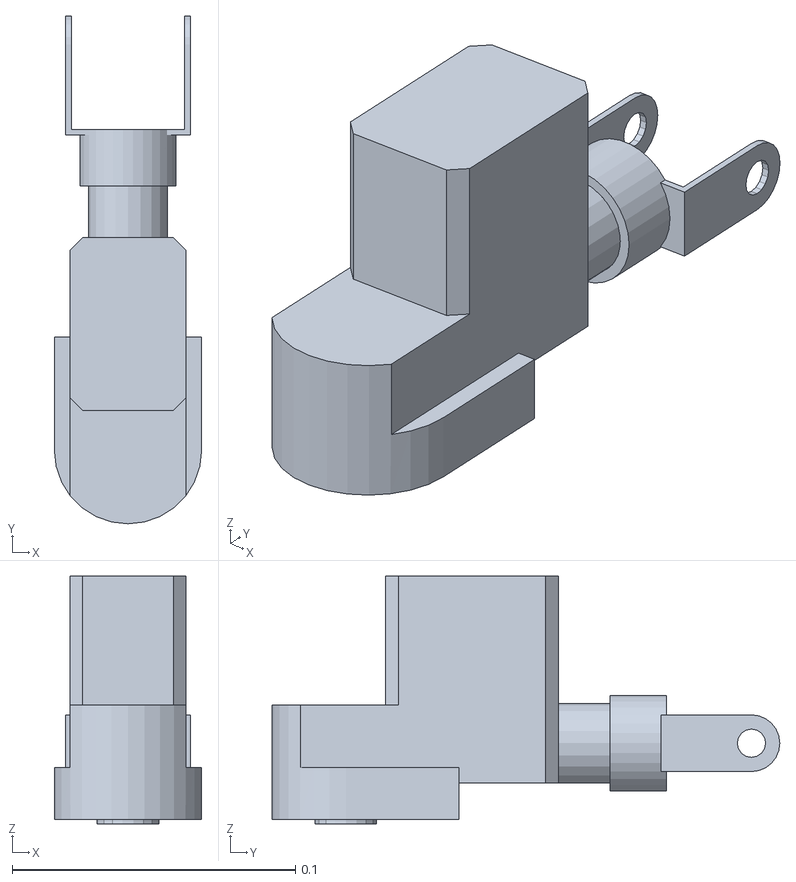
[picture p56: CAD file, 2016-05-09]
src/scara_setup_description/meshes/hand.STL
0.052 x 0.179 x 0.0875
