MinorAR/Fontys_SCARA_Arm/(list of files, cad)

Other CAD files:
CAD/effector1/for printing/effector.STL
CAD/effector1/klem effector.SLDPRT
CAD/end effector beugel.sldprt
CAD/ax12_box.sldprt
CAD/camera_sldprt.sldprt
CAD/ax12_wheel.sldprt
CAD/ax12_cog.sldprt
CAD/mechanical make parts cad/bevestigingsflens voor arm.SLDDRW
