MinorAR/Fontys_SCARA_Arm/img/global electrical setup.jpg

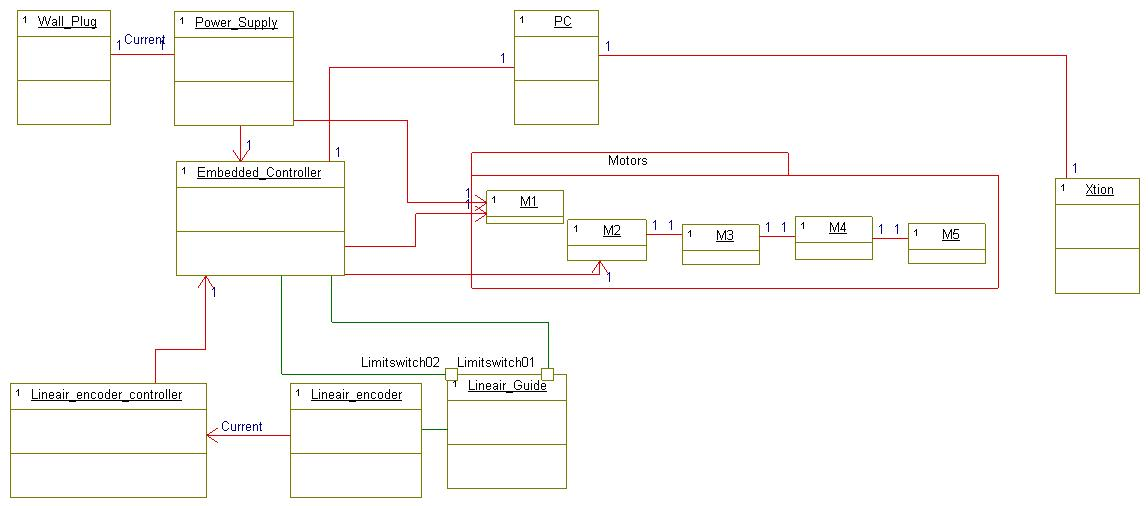
img/global electrical setup.jpg
