MinorAR/Fontys_SCARA_Arm/(threads)

Thread 32 (2016-04-11):

Mounting vision sensor

JRikken, 2016-04-11:
* Pick mounting location
* Documentation

JRikken, 2016-04-12:
* Kinect One (V2) has base distance 0.5m, can be mounted on the fore arm
* Kinect (V1) has base distance 0.8m and can only be mounted on the effector <- This would call for an enlarged safety cage

Closed 2016-04-18.

Thread 49 (2016-04-12):

Getting more done in GitHub with ZenHub

woutkanters, 2016-04-12:
Hola! @woutkanters has created a [ZenHub](http://www.zenhub.io) account for the **MinorAR** organization. ZenHub is the leading team collaboration and project management solution built for GitHub.

----

#### How do I use ZenHub?

To get set up with ZenHub, all you have to do is **[download the browser extension](https://www.zenhub.io?utm_source=ZHOnboarding)** and log in with your GitHub account. Once you do, you’ll get access to ZenHub’s complete feature-set immediately.

#### What can ZenHub do?

ZenHub adds a series of enhancements directly inside the GitHub UI:

- Real-time, customizable task boards for GitHub issues;
- Burndown charts, estimates, and velocity tracking based on GitHub Milestones;
- Personal to-do lists and task prioritization;
- “+1” button for GitHub issues and comments;
- Drag-and-drop file sharing;
- Time-saving shortcuts like a quick repo switcher.

### [Add ZenHub to GitHub](https://www.zenhub.io?utm_source=ZHOnboarding)

_Still curious? See [more ZenHub features](https://www.zenhub.io/features?utm_source=ZHOnboarding) or read [user reviews](https://chrome.google.com/webstore/detail/zenhub-for-github/ogcgkffhplmphkaahpmffcafajaocjbd/reviews). This issue was written by your friendly ZenHub bot, posted by request from @woutkanters._

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

Closed 2016-04-19.

Thread 52 (2016-04-12):

Create concept for endeffector

JRikken, 2016-04-12:
* Mounting of an additional motor
* How to connect to demo effector (paintbrush)
  * Insert in hole, lock with bolt
  * Simple collet mounting
* Total end effector can be 3D printed ??

Closed 2016-04-21.

Thread 65 (2016-04-18):

Get gazebo + ros_control + moveit up and running

JRikken, 2016-04-18:

JRikken, 2016-04-19:
* Edit drawings
* Rework the URDF model's package (correct base links / effector tip / change name (comply to gazebo tutorial))
* Follow gazebo tutorial to get everything up and running

http://gazebosim.org/tutorials?tut=ros_control
http://gazebosim.org/tutorials/?tut=ros_urdf

Closed 2016-04-22.

Thread 70 (2016-04-21):

Overhaul gazebo simulation

JRikken, 2016-04-21:
* Create proper URDF model
  * Correct masses
  * Set proper limits
  * Set proper speeds
* Use gazebo materials (and colours)
* Change controller values to more realistic values
* Limit the planning requests in MoveIt to avoid sending false goals ??
* Get rid of weird errors about goal targets etc.

Closed 2016-04-22.

Thread 73 (2016-04-21):

MoveIt not updating start state correctly

JRikken, 2016-04-21:
Is MoveIt connected to the right joint state??

Closed 2016-04-22.

Thread 75 (2016-04-21):

Change kinematics solver

JRikken, 2016-04-21:
Currently KDL (showing problems with rotation solving)

Apperantly KDL doesn't work properly with less than 6DOF systems.
IKFast is mentioned as a better solution for these systems

http://answers.ros.org/question/190808/using-moveit-to-control-the-end-of-a-hydraulic-arm-in-cartesian-coordinates/

JRikken, 2016-04-22:
or use TRAC-IK

JRikken, 2016-04-22:
We can now run:

* TRAC-IK
* KDL

Closed 2016-04-23.

Thread 85 (2016-04-30):

Fix the broken glue

JRikken, 2016-04-30:
The arm's second joint is loose

Closed 2016-05-23.

Thread 86 (2016-04-30):

Update URDF exporter model

JRikken, 2016-04-30:
* Add standardized coordinate systems to the joints to prevent the URDF exporter from coming up with it's own solution
* change base_link to frame to simplify copying into the existing URDF

Closed 2016-05-12.

Thread 87 (2016-04-30):

Investigate play

JRikken, 2016-04-30:
* There is a lot of play on the gears connecting the motors to the joints, perhaps this can be reduced

Thread 90 (2016-05-09):

Overcome angle limitations

JRikken, 2016-05-09:
currently 90deg for shoulder, elbow and wrist

can possibly be altered by using multiturn mode

JRikken, 2016-05-30:
Will be fixed by using absolute encoders mounted directly to the joints, as well as adding a local control  board to control the dynamixels in velocity mode

Thread 93 (2016-05-09):

Create dynamixel emulator module

JRikken, 2016-05-09:
* Based on Henk's code & propeller board
* Use dynamixel in speed mode & incremental linear encoder to emulate a dynamixel

JRikken, 2016-05-12:
No longer valid, now sending encoder values to ROS using rosserial & arduino mega. Controllers are now implemented in ROS using normal dynamixel controllers

Closed 2016-05-12.

Thread 94 (2016-05-10):

Check setting of PID gains

JRikken, 2016-05-10:
The PID gains of the dynamixels appear to be non persistent (maybe use in combination with dynamic reconfigure??)

JRikken, 2016-05-18:
No longer valid, will be solved by using *dynamixel_hr* to control the motors

Closed 2016-05-18.

Thread 96 (2016-05-11):

bug scara bringup launch

ruudvd, 2016-05-11:
ruud@ruud-Studio-1555:~/Fontys_SCARA_Arm/src/scara_setup_bringup/launch$ roslaunch scara_setup.launch  sim:=true
... logging to /home/ruud/.ros/log/1c11a7ba-1749-11e6-9b27-00216a63dd46/roslaunch-ruud-Studio-1555-3200.log
Checking log directory for disk usage. This may take awhile.
Press Ctrl-C to interrupt
Done checking log file disk usage. Usage is <1GB.

WARNING: Package name "SCARA_setup_moveit" does not follow the naming conventions. It should start with a lower case letter and only contain lower case letters, digits and underscores.
Traceback (most recent call last):
  File "/opt/ros/indigo/lib/python2.7/dist-packages/roslaunch/__init__.py", line 307, in main
    p.start()
  File "/opt/ros/indigo/lib/python2.7/dist-packages/roslaunch/parent.py", line 268, in start
    self._start_infrastructure()
  File "/opt/ros/indigo/lib/python2.7/dist-packages/roslaunch/parent.py", line 217, in _start_infrastructure
    self._load_config()
  File "/opt/ros/indigo/lib/python2.7/dist-packages/roslaunch/parent.py", line 132, in _load_config
    roslaunch_strs=self.roslaunch_strs, verbose=self.verbose)
  File "/opt/ros/indigo/lib/python2.7/dist-packages/roslaunch/config.py", line 451, in load_config_default
    loader.load(f, config, verbose=verbose)
  File "/opt/ros/indigo/lib/python2.7/dist-packages/roslaunch/xmlloader.py", line 746, in load
    self._load_launch(launch, ros_config, is_core=core, filename=filename, argv=argv, verbose=verbose)
  File "/opt/ros/indigo/lib/python2.7/dist-packages/roslaunch/xmlloader.py", line 718, in _load_launch
    self._recurse_load(ros_config, launch.childNodes, self.root_context, None, is_core, verbose)
  File "/opt/ros/indigo/lib/python2.7/dist-packages/roslaunch/xmlloader.py", line 662, in _recurse_load
    self._param_tag(tag, context, ros_config, verbose=verbose)
  File "/opt/ros/indigo/lib/python2.7/dist-packages/roslaunch/xmlloader.py", line 95, in call
    return f(*args, **kwds)
  File "/opt/ros/indigo/lib/python2.7/dist-packages/roslaunch/xmlloader.py", line 256, in _param_tag
    vals = self.opt_attrs(tag, context, ('value', 'textfile', 'binfile', 'command'))
  File "/opt/ros/indigo/lib/python2.7/dist-packages/roslaunch/xmlloader.py", line 202, in opt_attrs
    return [self.resolve_args(tag_value(tag,a), context) for a in attrs]
  File "/opt/ros/indigo/lib/python2.7/dist-packages/roslaunch/xmlloader.py", line 183, in resolve_args
    return substitution_args.resolve_args(args, context=context.resolve_dict, resolve_anon=self.resolve_anon)
  File "/opt/ros/indigo/lib/python2.7/dist-packages/roslaunch/substitution_args.py", line 312, in resolve_args
    resolved = _resolve_args(resolved, context, resolve_anon, commands)
  File "/opt/ros/indigo/lib/python2.7/dist-packages/roslaunch/substitution_args.py", line 325, in _resolve_args
    resolved = commands[command](resolved, a, args, context)
  File "/opt/ros/indigo/lib/python2.7/dist-packages/roslaunch/substitution_args.py", line 141, in _find
    source_path_to_packages=source_path_to_packages)
  File "/opt/ros/indigo/lib/python2.7/dist-packages/roslaunch/substitution_args.py", line 184, in _find_executable
    full_path = _get_executable_path(rp.get_path(args[0]), path)
  File "/usr/lib/python2.7/dist-packages/rospkg/rospack.py", line 200, in get_path
    raise ResourceNotFound(name, ros_paths=self._ros_paths)
ResourceNotFound: scara_setup_description
ROS path [0]=/opt/ros/indigo/share/ros
ROS path [1]=/home/jeroen/Software/scara_arm_ws/src
ROS path [2]=/home/ruud/catkin_ws/src
ROS path [3]=/opt/ros/indigo/share
ROS path [4]=/opt/ros/indigo/stacks

JRikken, 2016-05-11:
Sync with master branch, problem is allready solved

Closed 2016-05-11.

Thread 97 (2016-05-11):

Create install methods

JRikken, 2016-05-11:
* Fix trac-ik compilation errors
  * Don't edit the header file location in code (breaks sub-repo behaviour)
  * Create symlink using install script
* Add Arduino source code to the repo
* Remove rrbot & hector sub-repo's (no longer used)
* Stop using custom workspace name (this is a personal issue :))

JRikken, 2016-05-18:
Done and partially obsolete, clone repo with --recursive option, no more errors on trac-ik

Closed 2016-05-18.

Thread 107 (2016-05-12):

Create dynamixel control nodes

JRikken, 2016-05-12:
based on dynamixel_hr_ros and dynamixel_hr python library

JRikken, 2016-05-20:
This is now actually a dynamixel control *node*, one script which controls (and reads) all motors at once.

Following support needs to be added:

* dynamic reconfigure of motor PID gains
* flexible setting of connection information (terminal name, baudrate)

Closed 2016-05-23.

Thread 98 (2016-05-12):

Set up linear axis control

JRikken, 2016-05-12:
* PID controller position -> velocity
  * Possibly this can be done using standard ros_control controllers

JRikken, 2016-05-20:
Basic controller now exists based on position controllers, should be checked whether this can be done better by using the velocity controllers. This did not work at first, but there might have been an error in the instantiation of the velocity interface in the HWA layer. This should be checked.

Closed 2016-05-23.

Thread 111 (2016-05-17):

Check velocity limits

JRikken, 2016-05-17:
Speed limits in moveit cause weird behaviour.

JRikken, 2016-05-18:
Velocity limits could as well not be necessary, now disabled, no observable problems

Closed 2016-05-18.

Thread 114 (2016-05-18):

Extend linear axis control

JRikken, 2016-05-18:
* Add cogging to the HWA layer
* Add hard limiting of the linear axis to the HWA layer
  * Read the limit switches
  * Reset the encoder if necessary
* Add encoder reset option to the arduino code
* Kill motor's movement on shutdown of the HW control node
  * Velocity node leaves motor running on shutdown
* Add softstop
  * Don't enable excitation by default, update MoveIt positions first, to avoid jumps on startup

Closed 2016-05-26.

Thread 116 (2016-05-19):

fix temporary standard

CVH96, 2016-05-19:
mount guide on temporary standard

Closed 2016-05-23.

Thread 124 (2016-05-26):

Check stroke on linear axis

JRikken, 2016-05-26:
Lower limit switch will never be pressed (mechanical stop before limit switch pressed)

Maybe the linear encoder needs to be flipped

Closed 2016-05-27.

Thread 132 (2016-05-26):

Investigate serial port warnings

JRikken, 2016-05-26:
When running, the arduino (rosserial) periodically gives warnings about missing bytes

Possible causes:
* Baud rate too high
* Problems started after change to Float32, maybe this is not implemented properly?

JRikken, 2016-05-27:
Apperantly this dissapeared when the empty booleans where replaced with Empty messages, so probably not filling a message with rosserial causes some warnings.

Closed 2016-05-27.

Thread 139 (2016-06-06):

Design & manufacture PCB's

JRikken, 2016-06-06:
* Local controllers for dynamixels
  * Propeller mini
  * Connector for dynamixel
  * Connector for MAE encoders
  * Connectors for the DXL chain
* Arduino mega connection board
  * Connector for linear encoder
  * Connectors for the limit switches
* Renew cabling
