MinorAR/Fontys_SCARA_Arm/CAD/mechanical make parts cad/bevestigingsflens voor arm.PDF

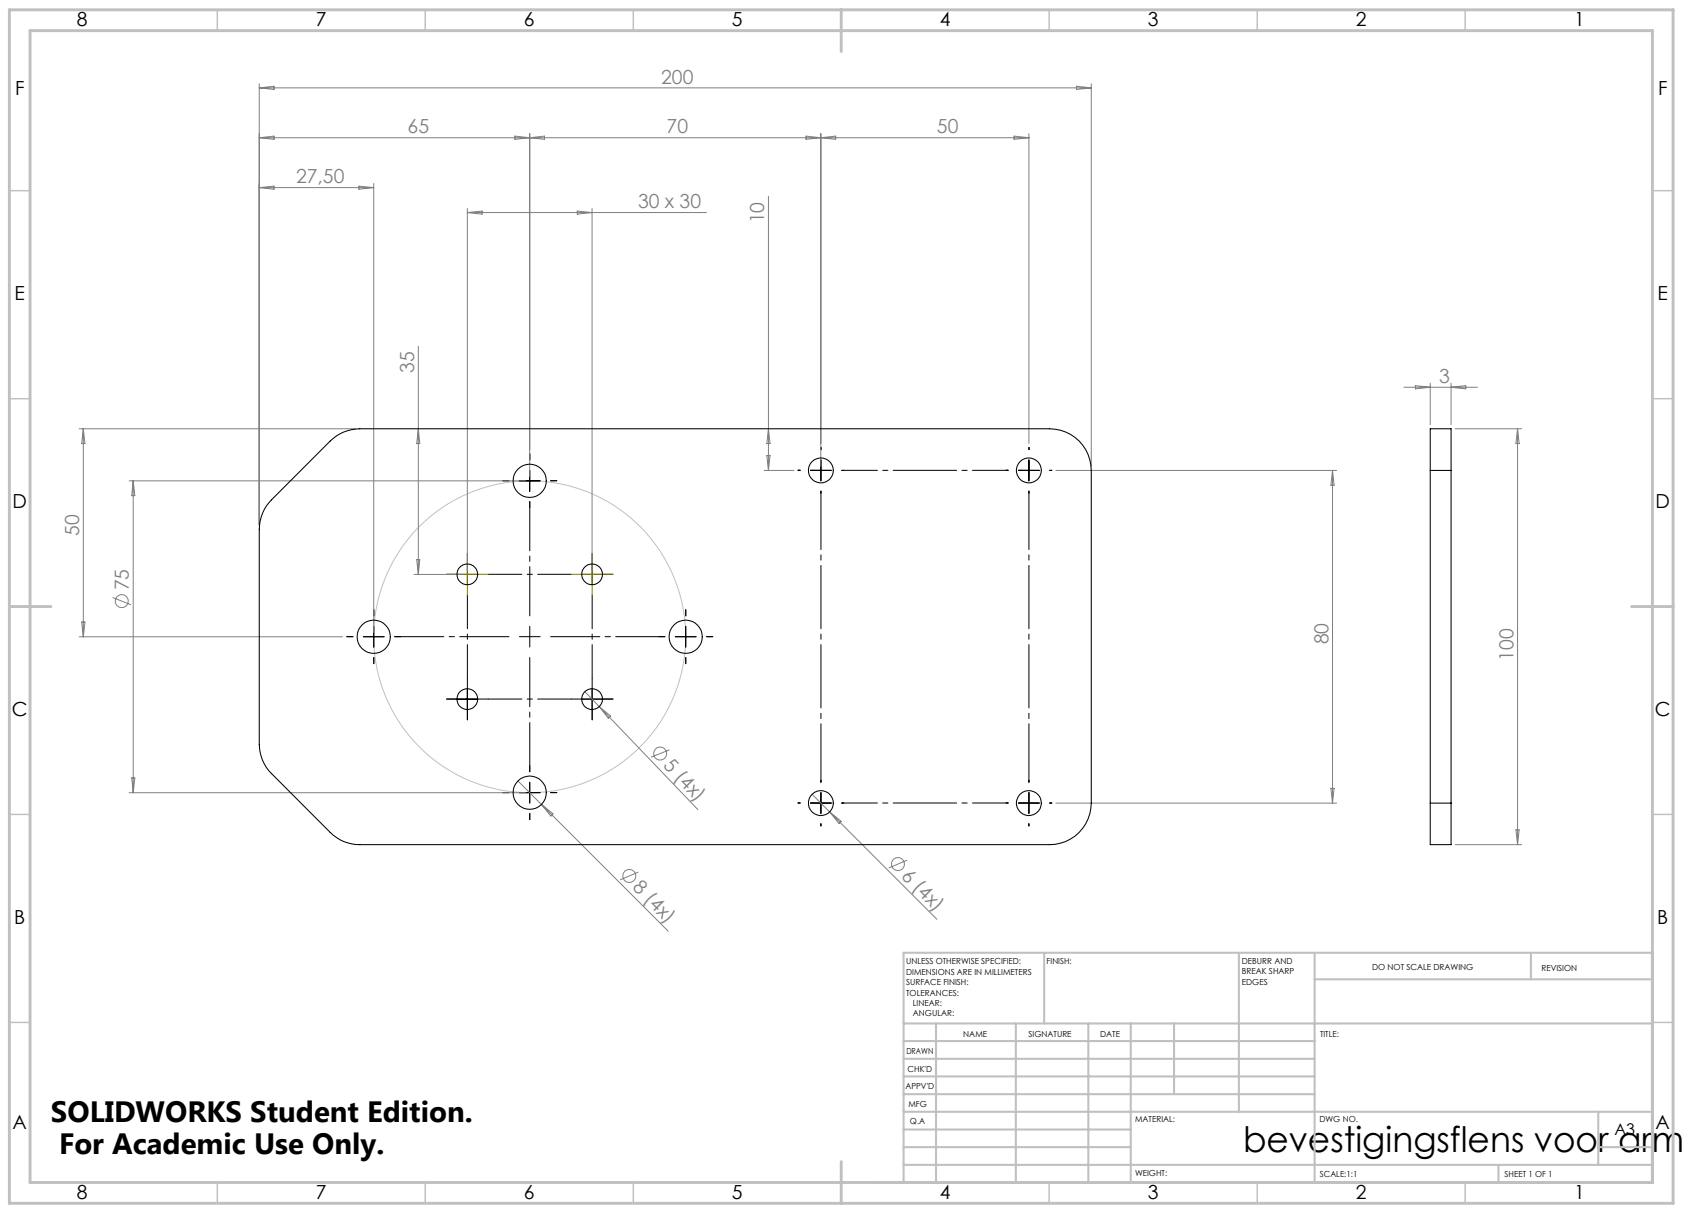
[picture p58: page 1]
FINISH:; DEBURR AND; BREAK SHARP; DO NOT SCALE DRAWING; REVISION; SCALE:1:1; SHEET 1 OF 1

UNLESS OTHERWISE SPECIFIED:
DIMENSIONS ARE IN MILLIMETERS
SURFACE FINISH:
TOLERANCES:
LINEAR:
ANGULAR:

NAME | SIGNATURE | DATE | | | | TITLE:

DRAWN
CHK'D
APPV'D
MFG
Q.A | | | | MATERIAL: | DWG NO. | A3

SOLIDWORKS Student Edition.
For Academic Use Only.

bevestigingsflens voor arm
