MinorAR/Fontys_SCARA_Arm/src/scara_setup_moveit/config/joint_limits.yaml

# joint_limits.yaml allows the dynamics properties specified in the URDF to be overwritten or augmented as needed
# Specific joint properties can be changed with the keys [max_position, min_position, max_velocity, max_acceleration]
# Joint limits can be turned off with [has_velocity_limits, has_acceleration_limits]
joint_limits:
  elbow:
    has_velocity_limits: true
    max_velocity: 3.295
    has_acceleration_limits: false
    max_acceleration: 0
  fingerjoint:
    has_velocity_limits: true
    max_velocity: 370.7
    has_acceleration_limits: false
    max_acceleration: 0
  linear:
    has_velocity_limits: true
    max_velocity: 0.0063
    has_acceleration_limits: false
    max_acceleration: 0
  shoulder:
    has_velocity_limits: true
    max_velocity: 3.295
    has_acceleration_limits: false
    max_acceleration: 0
  wrist:
    has_velocity_limits: true
    max_velocity: 3.295
    has_acceleration_limits: false
    max_acceleration: 0
