MinorAR/Fontys_SCARA_Arm/(commit log)

2016-04-11 Added MoveIt now correct
    [fake_controllers.yaml, joint_limits.yaml, scara.urdf, scara.urdf.xacro, test_setup1.urdf, test_setup1.urdf.xacro, test_setup2.urdf, test_setup2.urdf.xacro]
2016-04-18 Added new robot model and corresponding moveit package
    [Arm.STL, Cart.STL, Finger.STL, ForeArm.STL, Hand.STL, SCARA_setup_model.URDF, base_link.STL, fake_controllers.yaml]
2016-04-19 changed package names to lowercase to avoid errors, broke moveit package, reconfigure in next commit
    [Arm.STL, Cart.STL, Finger.STL, ForeArm.STL, Hand.STL, SCARA_setup_model.URDF, base_link.STL, fake_controllers.yaml]
2016-04-19 reconfigured moveit package out of edited robot model
    [Arm.STL, Cart.STL, Finger.STL, ForeArm.STL, Hand.STL, base_link.STL, fake_controllers.yaml, joint_limits.yaml]
2016-04-19 removed moveit again, adding baselinks & effector in urdf
    [fake_controllers.yaml, joint_limits.yaml]
2016-04-19 started on the gazebo tutorials
    [Arm.STL, Cart.STL, Finger.STL, ForeArm.STL, Hand.STL, base_link.STL, scara_setup.urdf]
2016-04-19 Edited the model files (taking rrbots files as a base) controllers remain not working, however, the model and controllers spawn correctly
    [scara_setup.urdf]
2016-04-21 MoveIt now working with Gazebo. Current problems: - PID controllers relatively weak (or the arm relatively heavy) - Linear axis not going up fully - Some warnings remain
    Issue #65
    [arm.STL, cart.STL, controllers.yaml, fake_controllers.yaml, finger.STL, forearm.STL, hand.STL, joint_limits.yaml]
2016-04-21 Moved scara_setup_gazebo package to scara_setup_bringup (will also contain hardware launch file in later stage)
2016-04-21 Edited the model and controllers, now acts like a servo based arm
    [arm.STL, cart.STL, finger.STL, joint_limits.yaml, scara_setup.urdf, scara_setup_joint_trajectory_controller.yaml]
2016-04-22 Removed old packages, preparing to merge new hardware control into master
    [Arm.STL, Cart.STL, Finger.STL, ForeArm.STL, Hand.STL, SCARA_setup_model.URDF, base_link.STL, fake_controllers.yaml]
2016-04-22 Re added accidentally removed stuff
    [arm.STL, base_link.STL, cart.STL, controllers.yaml, fake_controllers.yaml, finger.STL, forearm.STL, hand.STL]
2016-04-22 Set up the controller launch script properly (MoveIt setup assistant should now not try to overwrite it)
    Added the remap from joint_states to scara_setup/joint_states
    Maybe using the scara_setup namespace is not necessary and can be removed int the final product...
2016-04-25 Moved the dynamixel tests to proper control package, added all servos (except the linear control) All servos are now centered (zero is straight)
    [scara_setup_hw_controller.yaml]
2016-04-25 Split controller configs into gazebo & hardware version
    [scara_setup_joint_trajectory_controller.yaml, scara_setup_joint_trajectory_controller_gazebo.yaml]
2016-04-25 added hardware abstraction layer
    now able to:
    - run controllers position based
    - emulate moving robot by passing commands received from control directly to joint states
    next step:
    - for each motor instead of current behaviour, write and read to dynamixel controllers
2016-04-30 Wrist control working, editted topics in HWA, editted joint limits in URDF
    [scara_setup.urdf]
2016-04-30 Added other joints (except linear) to the HWA
2016-04-30 inverted shoulder motor in HWA
2016-04-30 Editted the URDF model (now proper arm lengths) Inverted the motors to go with the URDF change Now able to plan & execute trajectories on physical arm
    [arm.STL, cart.STL, finger.STL, forearm.STL, hand.STL, scara_setup.urdf]
2016-04-30 Added all joints to the RQT control_tuning perspective
2016-05-09 updated the URDF model, joint coordinate systems are now defined
    [arm.STL, base_link.STL, cart.STL, finger.STL, forearm.STL, frame.STL, hand.STL, scara_setup.urdf]
2016-05-12 Changed control values of the gazebo controllers
    [scara_setup_joint_trajectory_controller_gazebo.yaml]
2016-05-12 Changed control values of gazebo controller
    [scara_setup_joint_trajectory_controller_gazebo.yaml]
2016-05-12 Attempted to move linear axis to separate controller error on moveit_controller_manager parameter not set
    [controllers.yaml, joint_limits.yaml, scara_setup_joint_trajectory_controller_gazebo.yaml]
2016-05-12 Separated controllers into arm and linear section.
2016-05-12 * Added linear control to the HWA and controller system. * Separated linear axis to use velocity control instead of position. * Disabled all joints except linear in the HWA prior to testing * Now spa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
    [scara_setup_hw_controller.yaml, scara_setup_joint_trajectory_controller.yaml]
2016-05-12 Added arduino code (to read the linear encoder and send it's value as a ROS topic) is now added to the repo for version control
2016-05-17 add tf support capturing /world to /camera_base_link
    [scara_setup.urdf]
2016-05-17 Changed PID values & built
    [scara_setup_joint_trajectory_controller.yaml, scara_setup_joint_trajectory_controller_gazebo.yaml]
2016-05-17 Edited PID values
    [scara_setup_joint_trajectory_controller.yaml, scara_setup_joint_trajectory_controller_gazebo.yaml]
2016-05-17 Changed PID changes again. Also removed the speed limits on the joints, this removes weird behaviour in simulation.
    [joint_limits.yaml, scara_setup_joint_trajectory_controller_gazebo.yaml]
2016-05-17 changed hardware abstraction layer to add servo control node
    [scara_setup_joint_trajectory_controller.yaml]
2016-05-17 Created demo node controlling the fingerjoint
2016-05-18 Added demo nodes to control both the position and the velocity controlled joints. Just proof of concept, to be extended
    [scara_setup_joint_trajectory_controller.yaml]
2016-05-18 Moved linear encoder control (arduino code) to Float32 to save bandwith on the serial connection
2016-05-19 Linear axis now working! Control signals correct, design and responsibilities of modules should be checked
    [scara_setup_joint_trajectory_controller.yaml]
2016-05-19 Made setup demo ready, arm response is very slow, attempt was made to solve this
    [controllers.yaml, scara_setup_joint_trajectory_controller.yaml]
2016-05-23 Changed from dual joint trajectory controller to a single one (otherwise simulation wont work)
    [scara_setup_joint_trajectory_controller_gazebo.yaml]
2016-05-24 Gui added, as wel as manual control of the z axis and reset of encoder calibration
    [scara_setup_linear_encoder.ino]
2016-05-24 Debuggin on gui, moved all parts to single launch file, re-added joint limits to sync movements of the joints
    [joint_limits.yaml]
2016-05-24 Added indicators for limit switches and calibration status
2016-05-24 Added hard limiting to the motor control node
2016-05-25 added new capturing and filtering
2016-05-26 Changed unused boolean messages to Empty (to avoid confusion)
    [scara_setup_linear_encoder.ino]
2016-06-09 test version
    [scara_setup.urdf]
2016-06-15 added poster and CAD files
    [30x125.SLDPRT, 30x200.SLDPRT, 30x590.SLDPRT, 30x650.SLDPRT, 30x710.SLDPRT, 30x800.SLDPRT, AX12.SLDASM, Assem1.SLDASM]
2016-06-23 added encoders and collision object
